wwerst/EE91Fall2020/README.md

# EE91Fall2020
EE91 Fall 2020 project with Junno
