wwerst/EE91Fall2020/CDR_Presentation.pdf

# Time-Domain Reflectometer CDR

Will Werst and Junno Tseng

High-Level Block Diagram

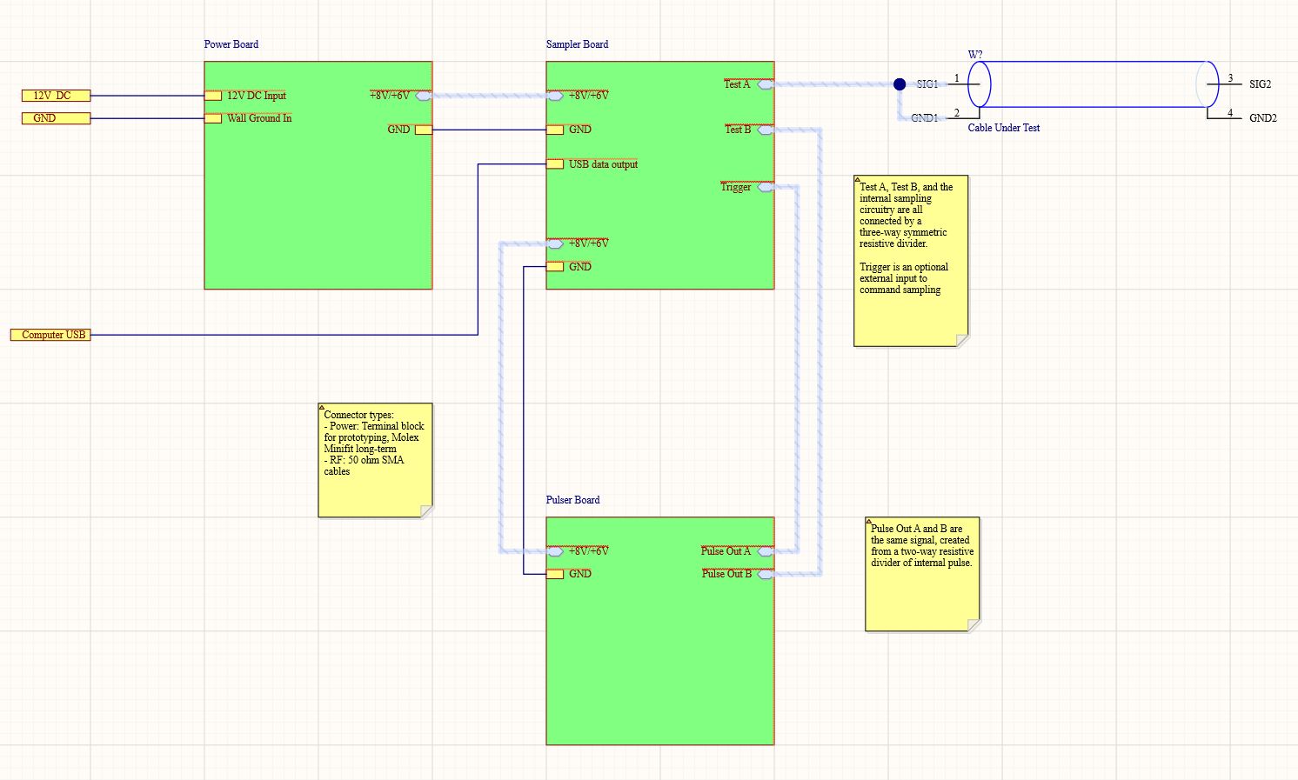
[picture p1: figure]
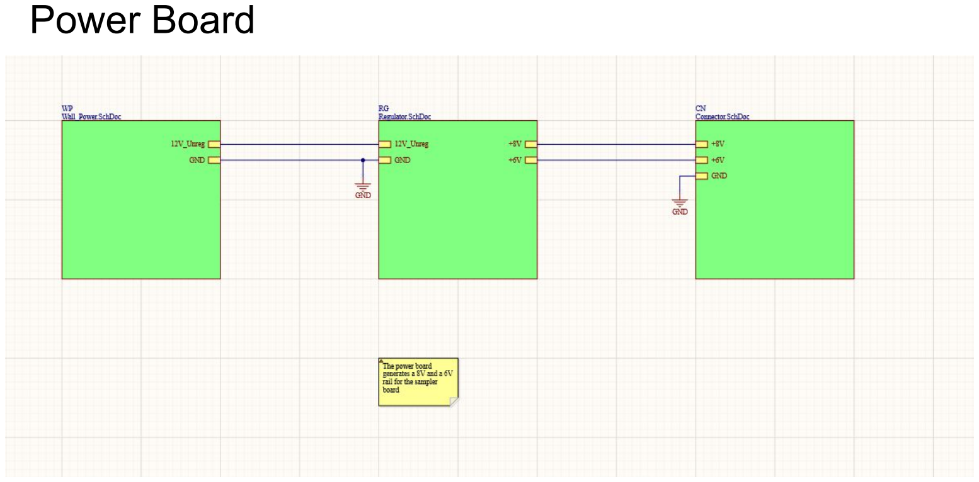
[picture p2: page 3]

Power Board

Pulser Board

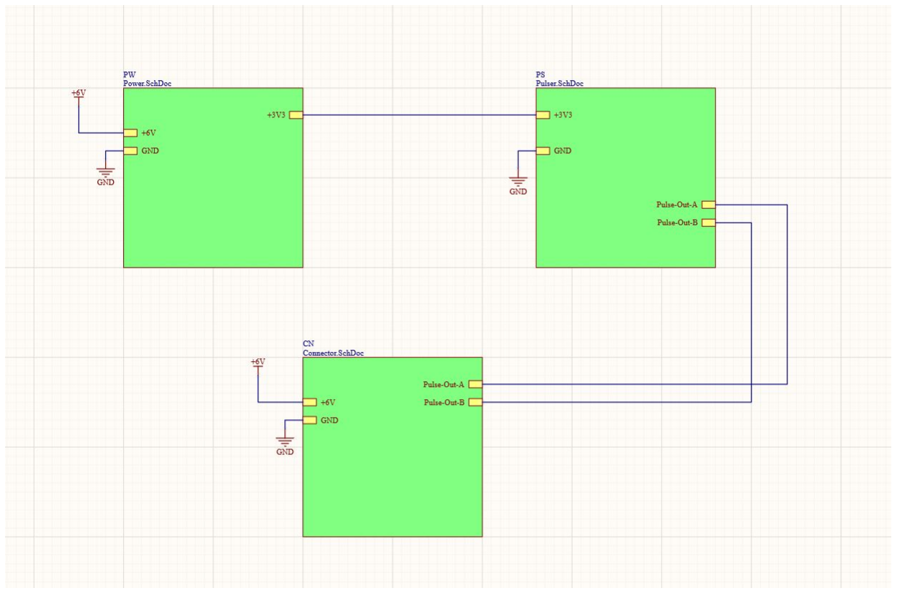
[picture p3: figure]

Sampler Board

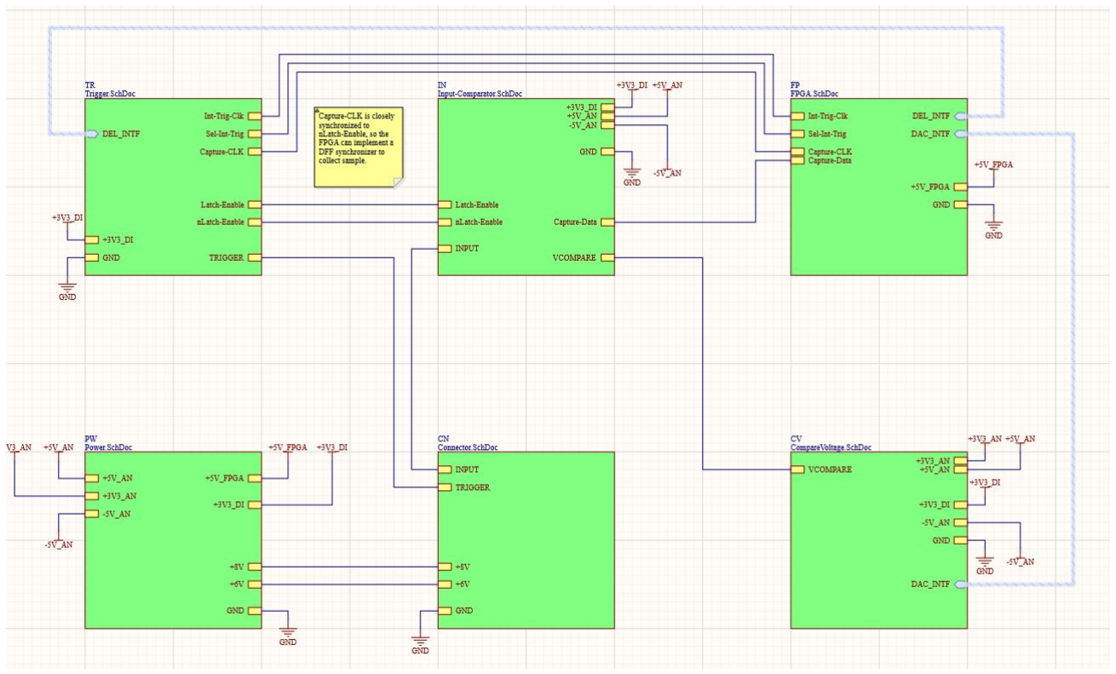
[picture p4: figure]

Power Board BOM

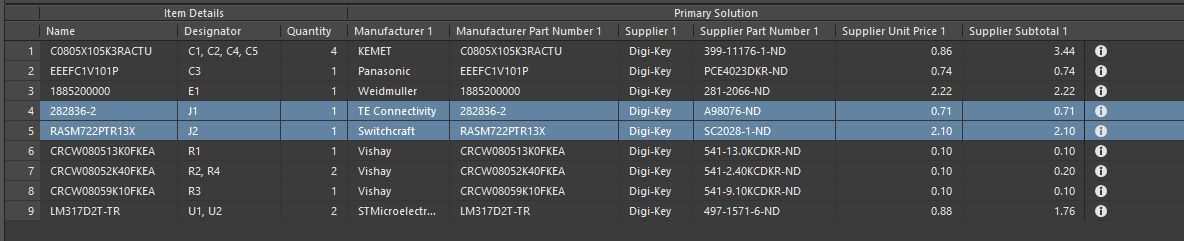
[picture p5: figure]

Pulse Board BOM

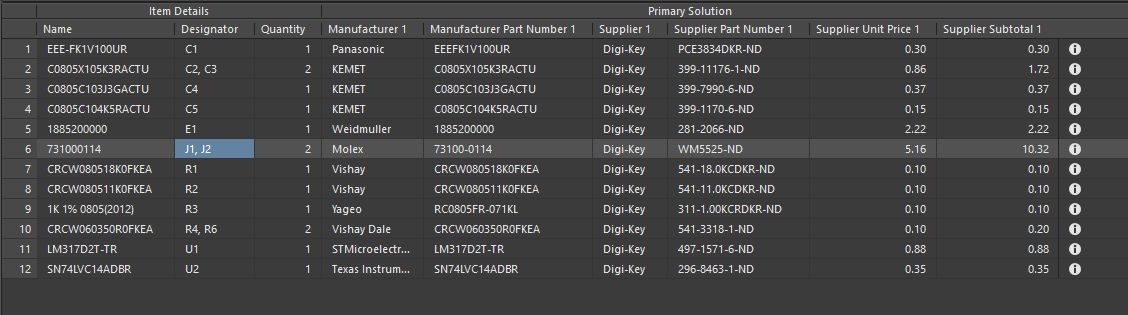
[picture p6: figure]

Sampler Board BOM

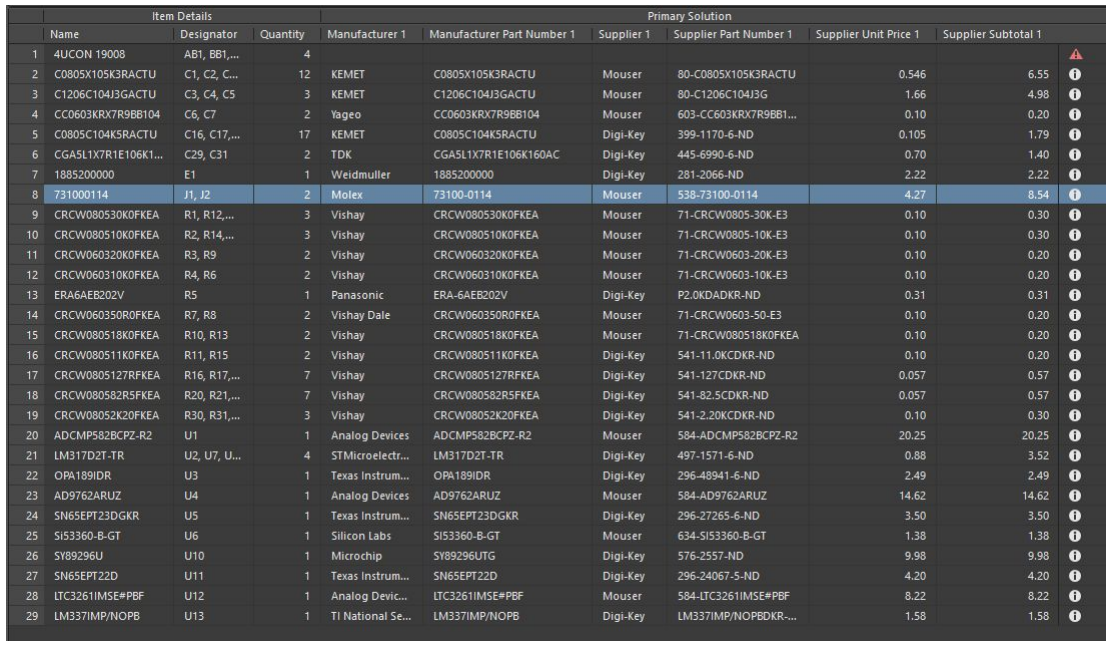
[picture p7: figure]

Move to Altium

See PDF of schematics as well

Appendix

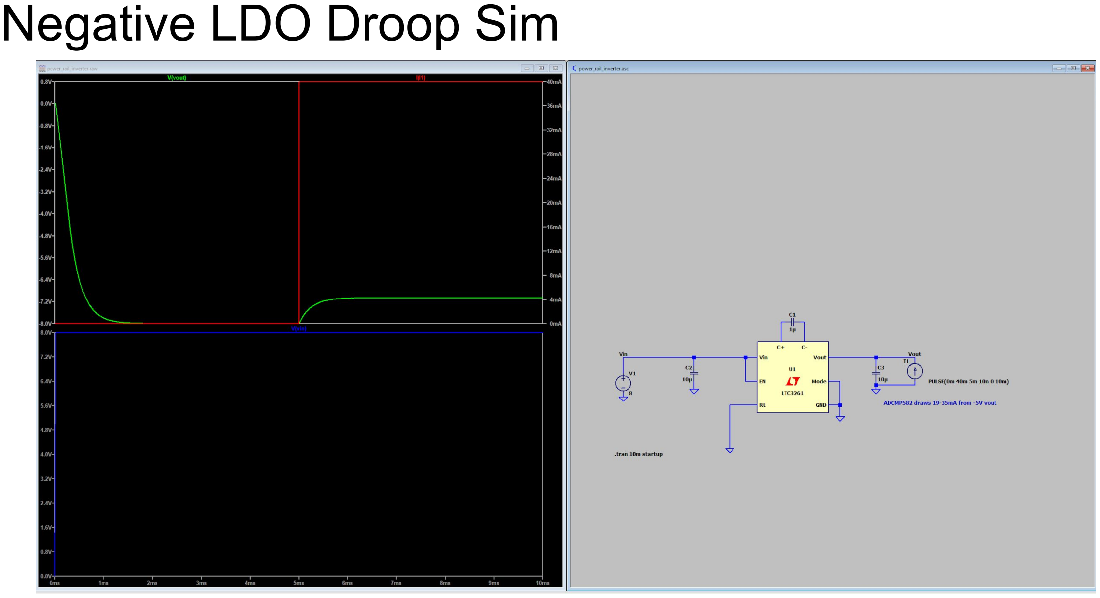
[picture p8: page 11]

Negative LDO Droop Sim
