wwerst/EE91Fall2020/PowerBoard/PowerBoard_BOM.xlsx

Name | Designator | Quantity | Manufacturer 1 | Manufacturer Part Number 1 | Supplier 1 | Supplier Part Number 1 | Supplier Unit Price 1 | Supplier Subtotal 1
C0805X105K3RACTU | C1, C2, C4, C5 | 4 | KEMET | C0805X105K3RACTU | Digi-Key | 399-11176-1-ND | $0.86 | $3.44
EEEFC1V101P | C3 | 1 | Panasonic | EEEFC1V101P | Digi-Key | PCE4023DKR-ND | $0.74 | $0.74
1885200000 | E1 | 1 | Weidmuller | 1885200000 | Digi-Key | 281-2066-ND | $2.22 | $2.22
282836-2 | J1 | 1 | TE Connectivity | 282836-2 | Digi-Key | A98076-ND | $0.71 | $0.71
RASM722PTR13X | J2 | 1 | Switchcraft | RASM722PTR13X | Digi-Key | SC2028-6-ND | $2.10 | $2.10
CRCW080513K0FKEA | R1 | 1 | Vishay | CRCW080513K0FKEA | Digi-Key | 541-13.0KCDKR-ND | $0.10 | $0.10
CRCW08052K40FKEA | R2, R4 | 2 | Vishay | CRCW08052K40FKEA | Digi-Key | 541-2.40KCDKR-ND | $0.10 | $0.20
CRCW08059K10FKEA | R3 | 1 | Vishay | CRCW08059K10FKEA | Digi-Key | 541-9.10KCDKR-ND | $0.10 | $0.10
LM317D2T-TR | U1, U2 | 2 | STMicroelectronics | LM317D2T-TR | Digi-Key | 497-1571-6-ND | $0.88 | $1.76
 |  |  |  |  |  |  | Total | $11.37
