wwerst/EE91Fall2020/PulseBoard/PulseBoard_BOM.xlsx

Name | Designator | Quantity | Manufacturer 1 | Manufacturer Part Number 1 | Supplier 1 | Supplier Part Number 1 | Supplier Unit Price 1 | Supplier Subtotal 1
EEE-FK1V100UR | C1 | 1 | Panasonic | EEEFK1V100UR | Digi-Key | PCE3834DKR-ND | $0.30 | $0.30
C0805X105K3RACTU | C2, C3 | 2 | KEMET | C0805X105K3RACTU | Digi-Key | 399-11176-1-ND | $0.86 | $1.72
C0805C103J3GACTU | C4 | 1 | KEMET | C0805C103J3GACTU | Digi-Key | 399-7990-6-ND | $0.37 | $0.37
C0805C104K5RACTU | C5 | 1 | KEMET | C0805C104K5RACTU | Digi-Key | 399-1170-6-ND | $0.15 | $0.15
1885200000 | E1 | 1 | Weidmuller | 1885200000 | Digi-Key | 281-2066-ND | $2.22 | $2.22
731000114 | J1, J2 | 2 | Molex | 73100-0114 | Digi-Key | WM5525-ND | $5.16 | $10.32
CRCW080518K0FKEA | R1 | 1 | Vishay | CRCW080518K0FKEA | Digi-Key | 541-18.0KCDKR-ND | $0.10 | $0.10
CRCW080511K0FKEA | R2 | 1 | Vishay | CRCW080511K0FKEA | Digi-Key | 541-11.0KCCT-ND | $0.10 | $0.10
1K 1% 0805(2012) | R3 | 1 | Yageo | RC0805FR-071KL | Digi-Key | 311-1.00KCRDKR-ND | $0.10 | $0.10
CRCW060350R0FKEA | R4, R6 | 2 | Vishay Dale | CRCW060350R0FKEA | Digi-Key | 541-3318-6-ND | $0.10 | $0.20
LM317D2T-TR | U1 | 1 | STMicroelectronics | LM317D2T-TR | Digi-Key | 497-1571-6-ND | $0.88 | $0.88
SN74LVC14ADBR | U2 | 1 | Texas Instruments | SN74LVC14ADBR | Digi-Key | 296-8463-1-ND | $0.35 | $0.35
 |  |  |  |  |  |  | Total Cost | $16.81
