wwerst/EE91Fall2020/SamplerBoard/SamplerBoard_BOM.xlsx

Name | Designator | Quantity | Manufacturer 1 | Manufacturer Part Number 1 | Supplier 1 | Supplier Part Number 1 | Supplier Unit Price 1 | Supplier Subtotal 1
4UCON 19008 | AB1, BB1, CB1, DB1 | 4 |  |  | Sparkfun | PRT-16890 | $1.50 | $6.00
5001 | TP1, TP2, TP7, TP8, TP9, TP10, TP11, TPGND1, TPGND2, TPGND3, TPGND4 | 11 | Keystone Electronics | 5001 | Digi-Key | 36-5001-ND | $0.40 | $4.40
731000114 | J1, J2 | 2 | Molex | 73100-0114 | Digi-Key | WM5525-ND | $5.16 | $10.32
1885200000 | E1 | 1 | Weidmuller | 1885200000 | Digi-Key | 281-2066-ND | $2.22 | $2.22
AD9762ARUZ | U4 | 1 | Analog Devices | AD9762ARUZ | Digi-Key | AD9762ARUZ-ND | $14.62 | $14.62
C0402C104K8PACTU | C14, C16, C17, C18, C19, C21, C22, C33 | 8 | KEMET | C0402C104K8PACTU | Digi-Key | 399-3027-6-ND | $0.04 | $0.32
C0805C104K5RACTU | C23, C24, C25, C26, C27, C28, C35, C36 | 8 | KEMET | C0805C104K5RACTU | Digi-Key | 399-1170-6-ND | $0.10 | $0.84
CC0603KRX7R9BB104 | C6, C7 | 2 | Yageo | CC0603KRX7R9BB104 | Digi-Key | 311-1344-6-ND | $0.10 | $0.20
CGA5L1X7R1E106K160AC | C29, C31 | 2 | TDK | CGA5L1X7R1E106K160AC | Digi-Key | 445-6990-6-ND | $0.70 | $1.40
CRCW08052K20FKEA | R30, R31, R32 | 3 | Vishay | CRCW08052K20FKEA | Digi-Key | 541-2.20KCDKR-ND | $0.10 | $0.30
CRCW060310K0FKEA | R4, R6 | 2 | Vishay | CRCW060310K0FKEA | Digi-Key | 541-10.0KHDKR-ND | $0.10 | $0.20
CRCW060320K0FKEA | R3, R9 | 2 | Vishay | CRCW060320K0FKEA | Digi-Key | 541-20.0KHDKR-ND | $0.10 | $0.20
CRCW060350R0FKEA | R7, R8 | 2 | Vishay Dale | CRCW060350R0FKEA | Digi-Key | 541-3318-6-ND | $0.10 | $0.20
CRCW080510K0FKEA | R2, R14, R34 | 3 | Vishay | CRCW080510K0FKEA | Digi-Key | 541-10.0KCDKR-ND | $0.10 | $0.30
CRCW080511K0FKEA | R11, R15 | 2 | Vishay | CRCW080511K0FKEA | Digi-Key | 541-11.0KCDKR-ND | $0.10 | $0.20
CRCW080518K0FKEA | R10, R13 | 2 | Vishay | CRCW080518K0FKEA | Digi-Key | 541-18.0KCDKR-ND | $0.10 | $0.20
CRCW080530K0FKEA | R1, R12, R33 | 3 | Vishay | CRCW080530K0FKEA | Digi-Key | 541-30.0KCDKR-ND | $0.10 | $0.30
ERA6AEB202V | R5 | 1 | Panasonic | ERA-6AEB202V | Digi-Key | P2.0KDADKR-ND | $0.31 | $0.31
LM317D2T-TR | U2, U7, U8, U9 | 4 | STMicroelectronics | LM317D2T-TR | Digi-Key | 497-1571-6-ND | $0.88 | $3.52
LM337IMP/NOPB | U13 | 1 | TI National Semiconductor | LM337IMP/NOPB | Digi-Key | LM337IMP/NOPBDKR-ND | $1.58 | $1.58
LTC3261IMSE#PBF | U12 | 1 | Analog Devices / Linear Technology | LTC3261IMSE#PBF | Digi-Key | LTC3261IMSE#PBF-ND | $8.24 | $8.24
OPA189IDR | U3 | 1 | Texas Instruments | OPA189IDR | Digi-Key | 296-48941-6-ND | $2.49 | $2.49
RC0402FR-0782R5L | R20, R21, R22, R23, R25 | 5 | Yageo | RC0402FR-0782R5L | Digi-Key | 311-82.5LRDKR-ND | $0.01 | $0.07
RC0402FR-07127RL | R16, R17, R18, R19, R24 | 5 | Yageo | RC0402FR-07127RL | Digi-Key | YAG2963DKR-ND | $0.01 | $0.07
SN65EPT22D | U11 | 1 | Texas Instruments | SN65EPT22D | Digi-Key | 296-24067-5-ND | $4.20 | $4.20
SN65EPT23DGKR | U5 | 1 | Texas Instruments | SN65EPT23DGKR | Digi-Key | 296-27265-6-ND | $3.50 | $3.50
127 Ohm | R26, R27 | 2 | Vishay | CRCW0805127RFKEA | Mouser | 71-CRCW0805127RFKEA | $0.10 | $0.20
ADCMP582BCPZ-R2 | U1 | 1 | Analog Devices | ADCMP582BCPZ-R2 | Mouser | 584-ADCMP582BCPZ-R2 | $20.25 | $20.25
C0805X105K3RACTU | C1, C2, C8, C9, C10, C11, C12, C13, C15, C30, C32 | 11 | KEMET | C0805X105K3RACTU | Mouser | 80-C0805X105K3RACTU | $0.55 | $6.01
C1206C104J3GACTU | C3, C4, C5 | 3 | KEMET | C1206C104J3GACTU | Mouser | 80-C1206C104J3G | $1.66 | $4.98
CRCW080582R5FKEA | R28, R29 | 2 | Vishay | CRCW080582R5FKEA | Mouser | 71-CRCW0805-82.5-E3 | $0.10 | $0.20
Si53360-B-GT | U6 | 1 | Silicon Labs | SI53360-B-GT | Mouser | 634-SI53360-B-GT | $1.38 | $1.38
Variable Digital Delay | U10 | 1 | Microchip | SY89296UTG | Mouser | 998-SY89296UTG | $9.98 | $9.98
 |  |  |  |  |  |  | Total Cost | $109.20
