wwerst/EE91Fall2020/CDR_Schematics.pdf

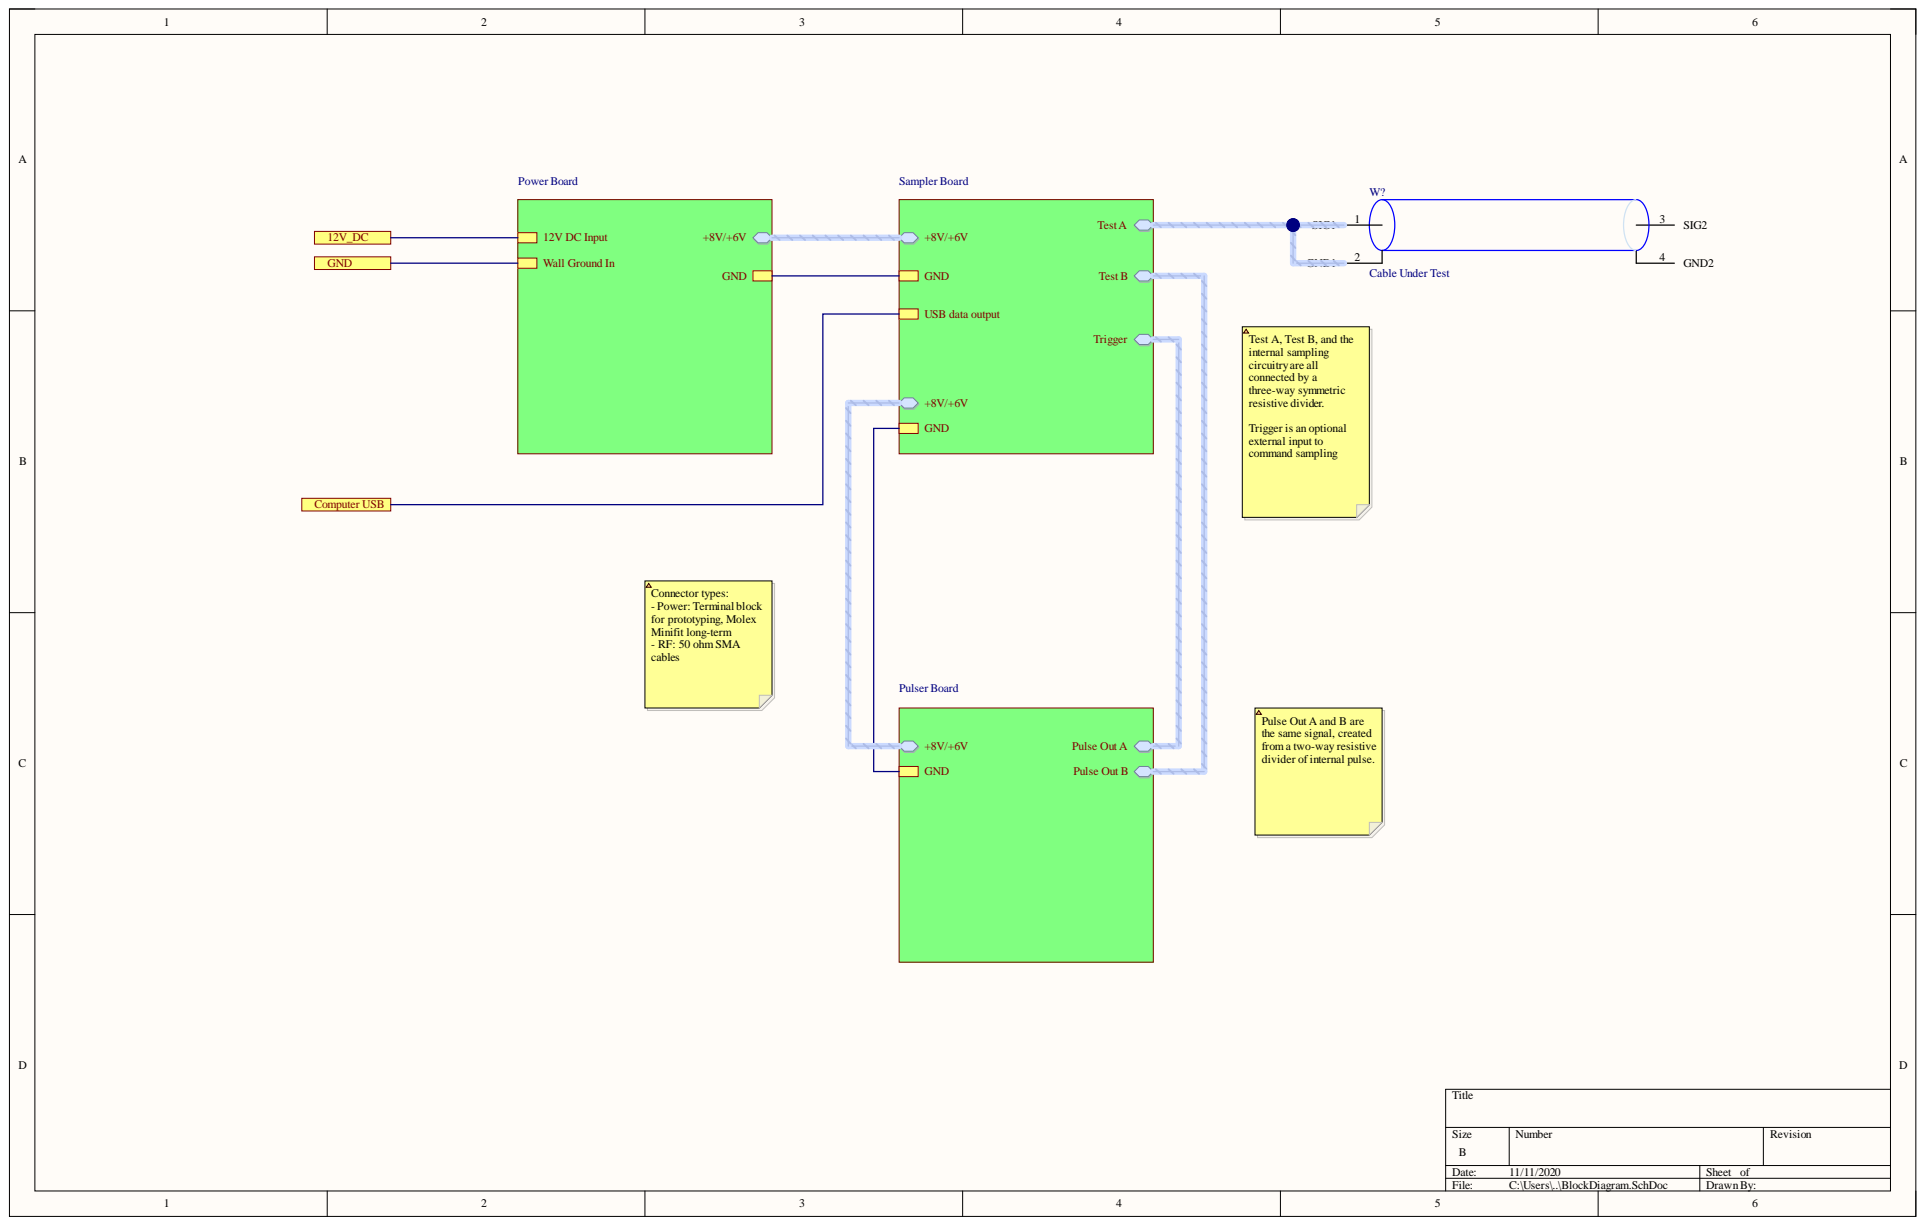
[picture p9: page 1]

Test A, Test B, and the
internal sampling
circuitryare all
connected by a
three-way symmetric
resistive divider.

Trigger is an optional
external input to
command sampling

Pulse Out A and B are
the same signal, created
from a two-way resistive
divider of internal pulse.

Size B | Number | Revision

Date: 11/11/2020 | Sheet of
File: C:\Users\..\BlockDiagram.SchDoc | DrawnBy:

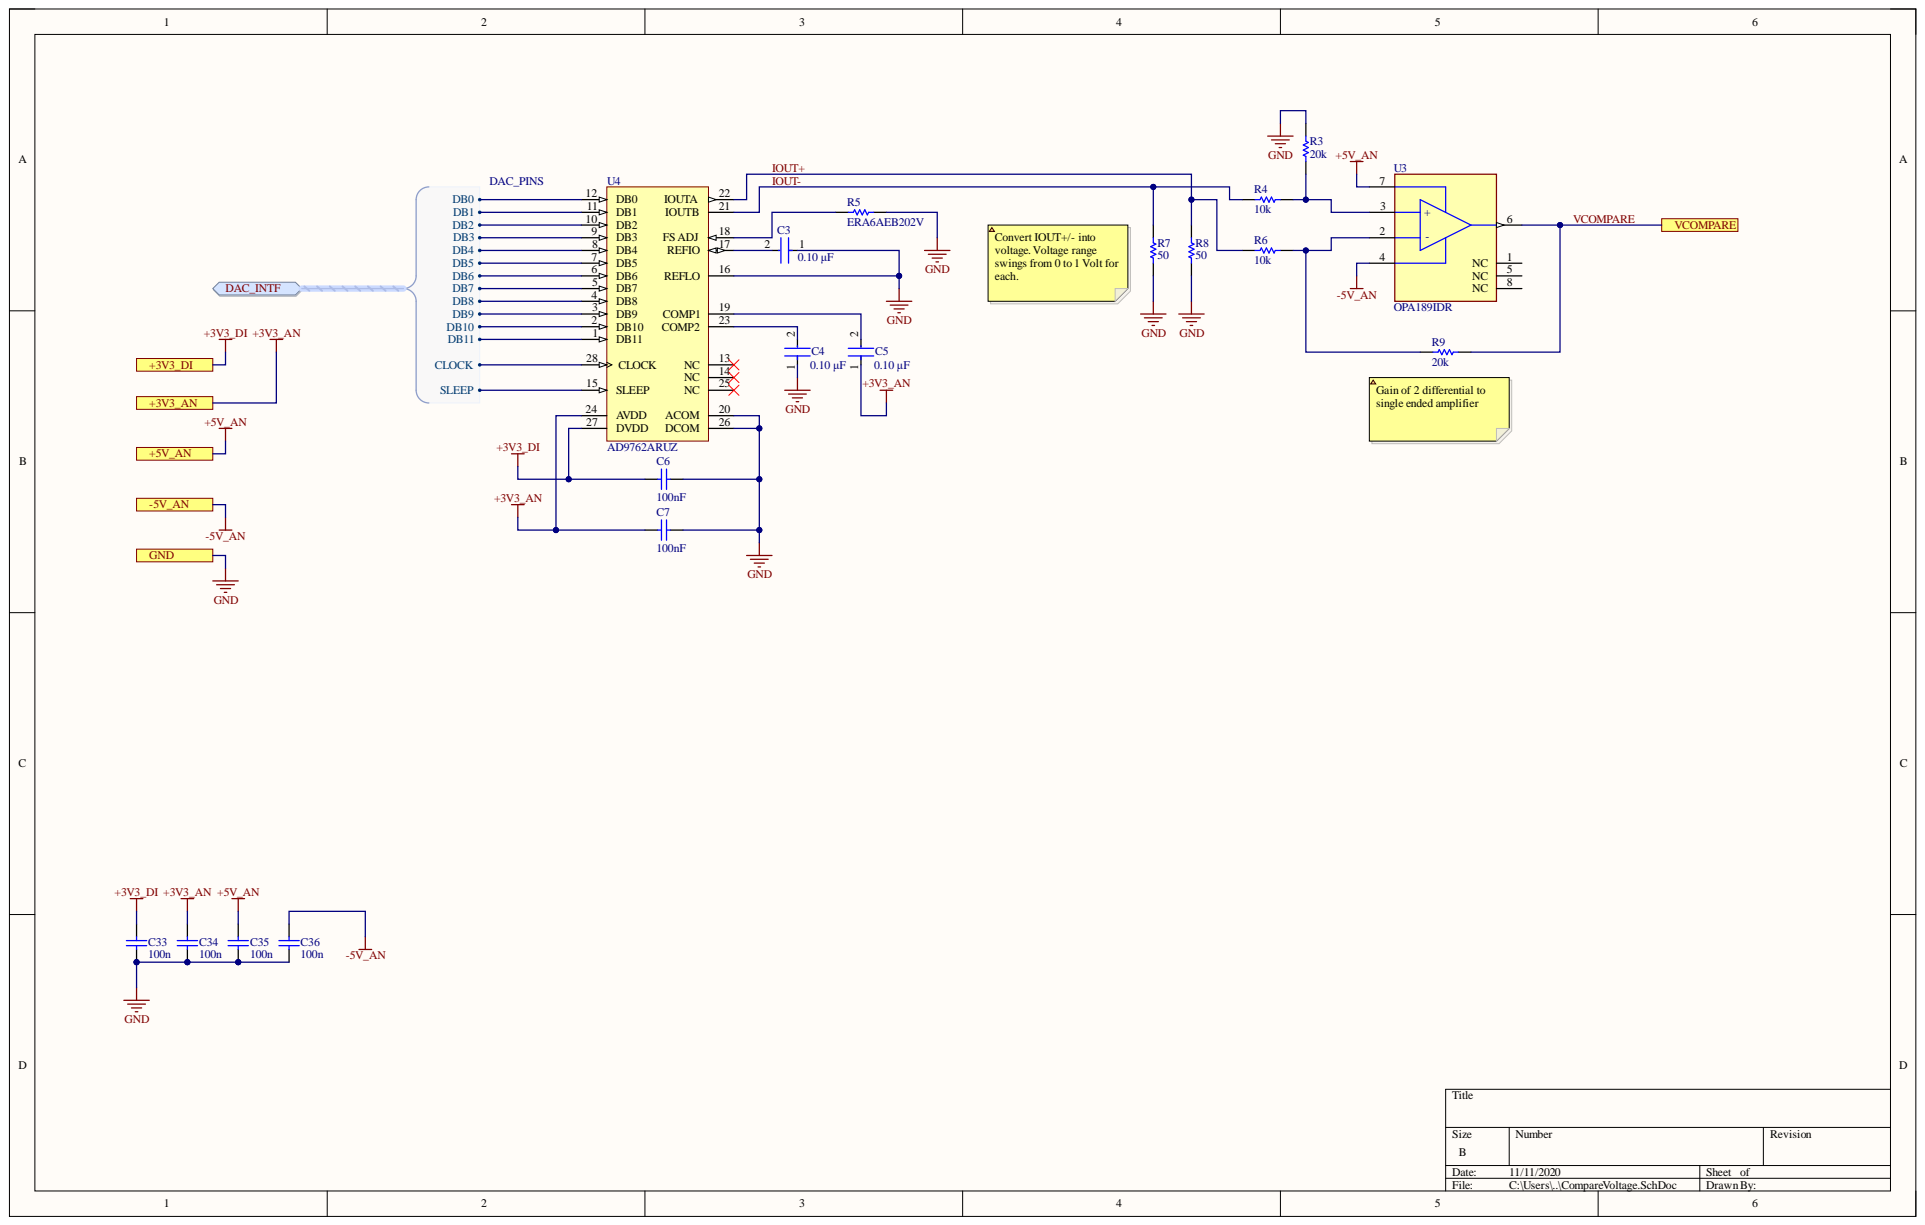
[picture p10: page 2]

Convert IOUT+/- into
voltage. Voltage range
swings from 0 to 1 Volt for
each.

Gain of 2 differential to
single ended amplifier

Size B | Number | Revision

Date: 11/11/2020 | Sheet of
File: C:\Users\..\CompareVoltage.SchDoc | DrawnBy:

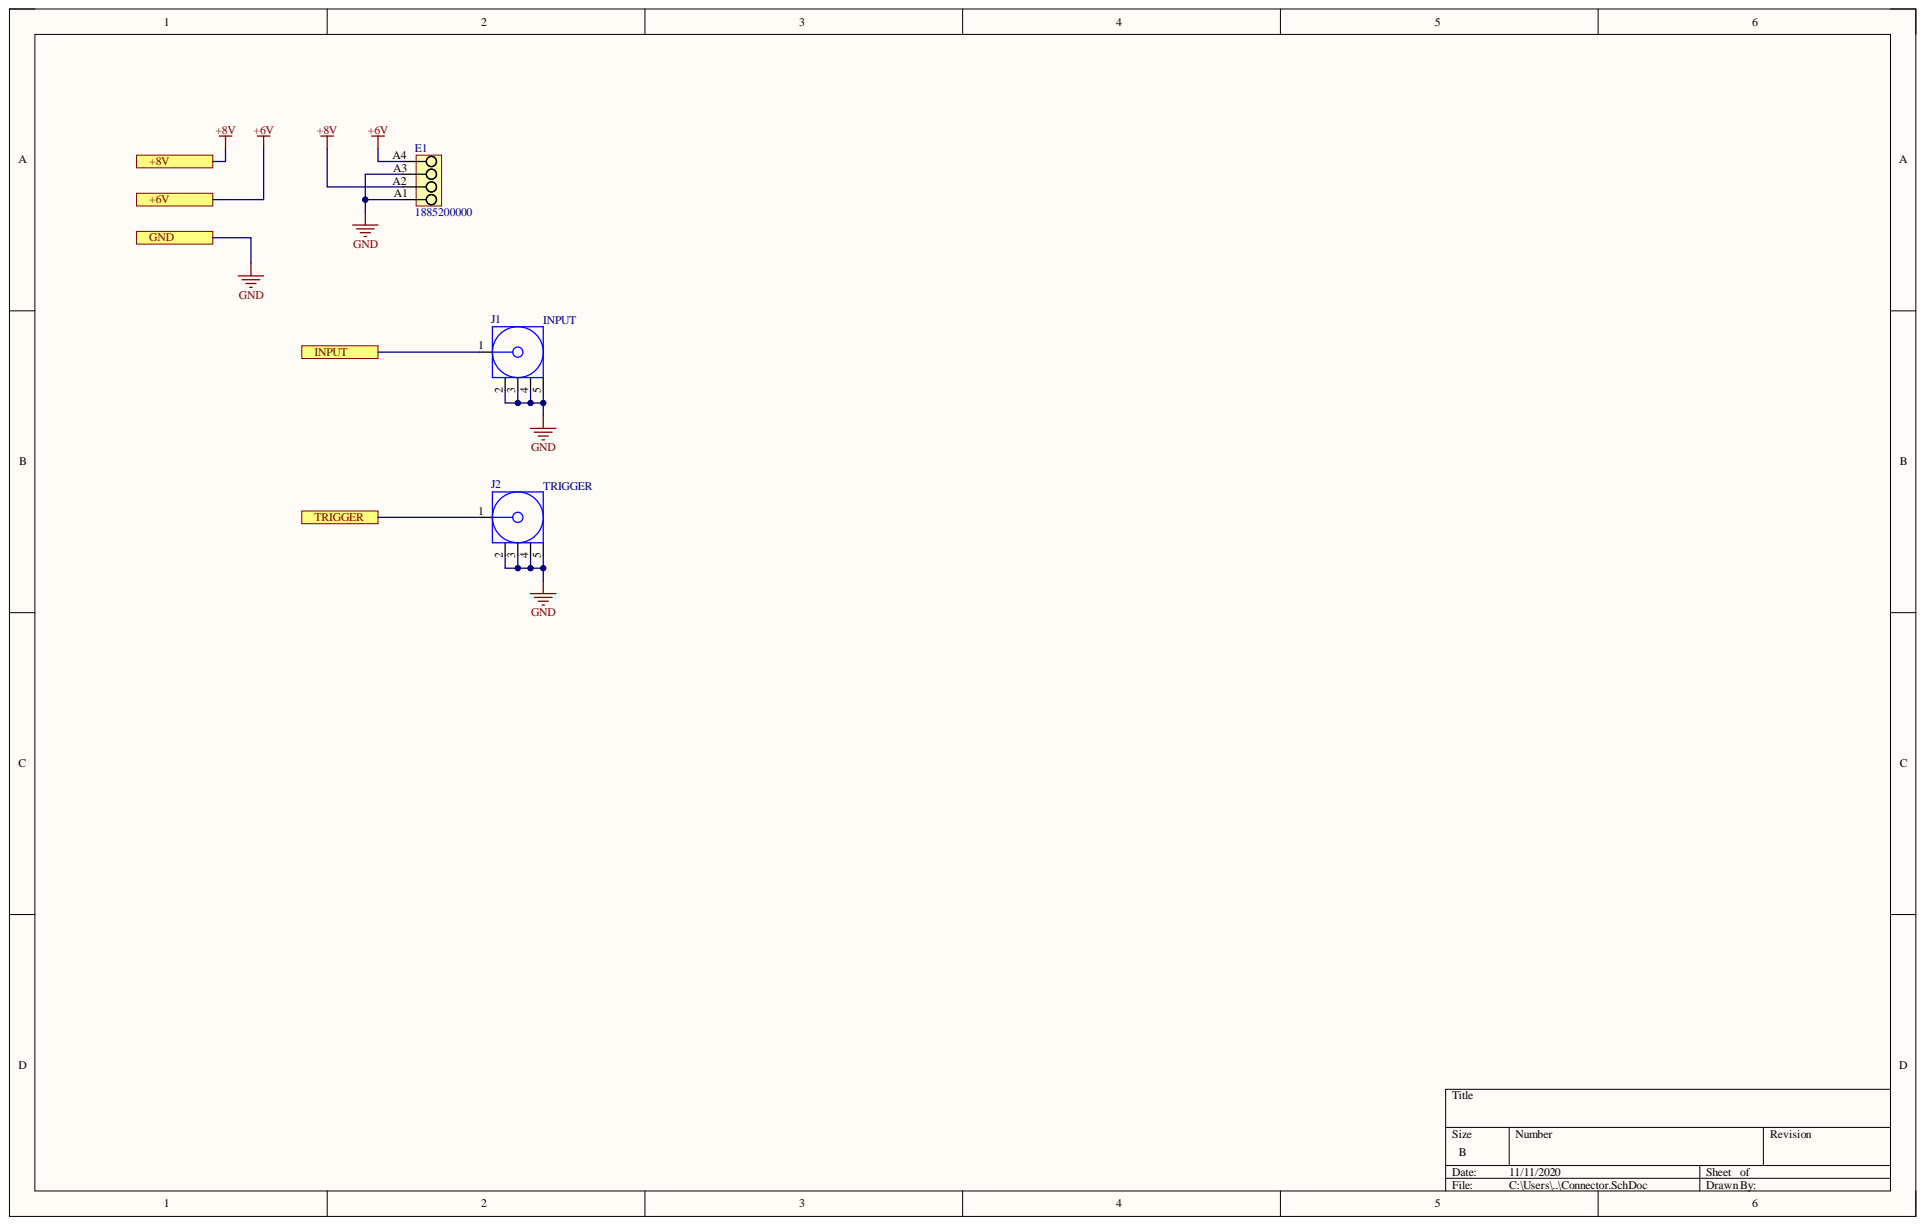
[picture p11: page 3]

Size B | Number | Revision

Date: 11/11/2020 | Sheet of
File: C:\Users\..\Connector.SchDoc | DrawnBy:

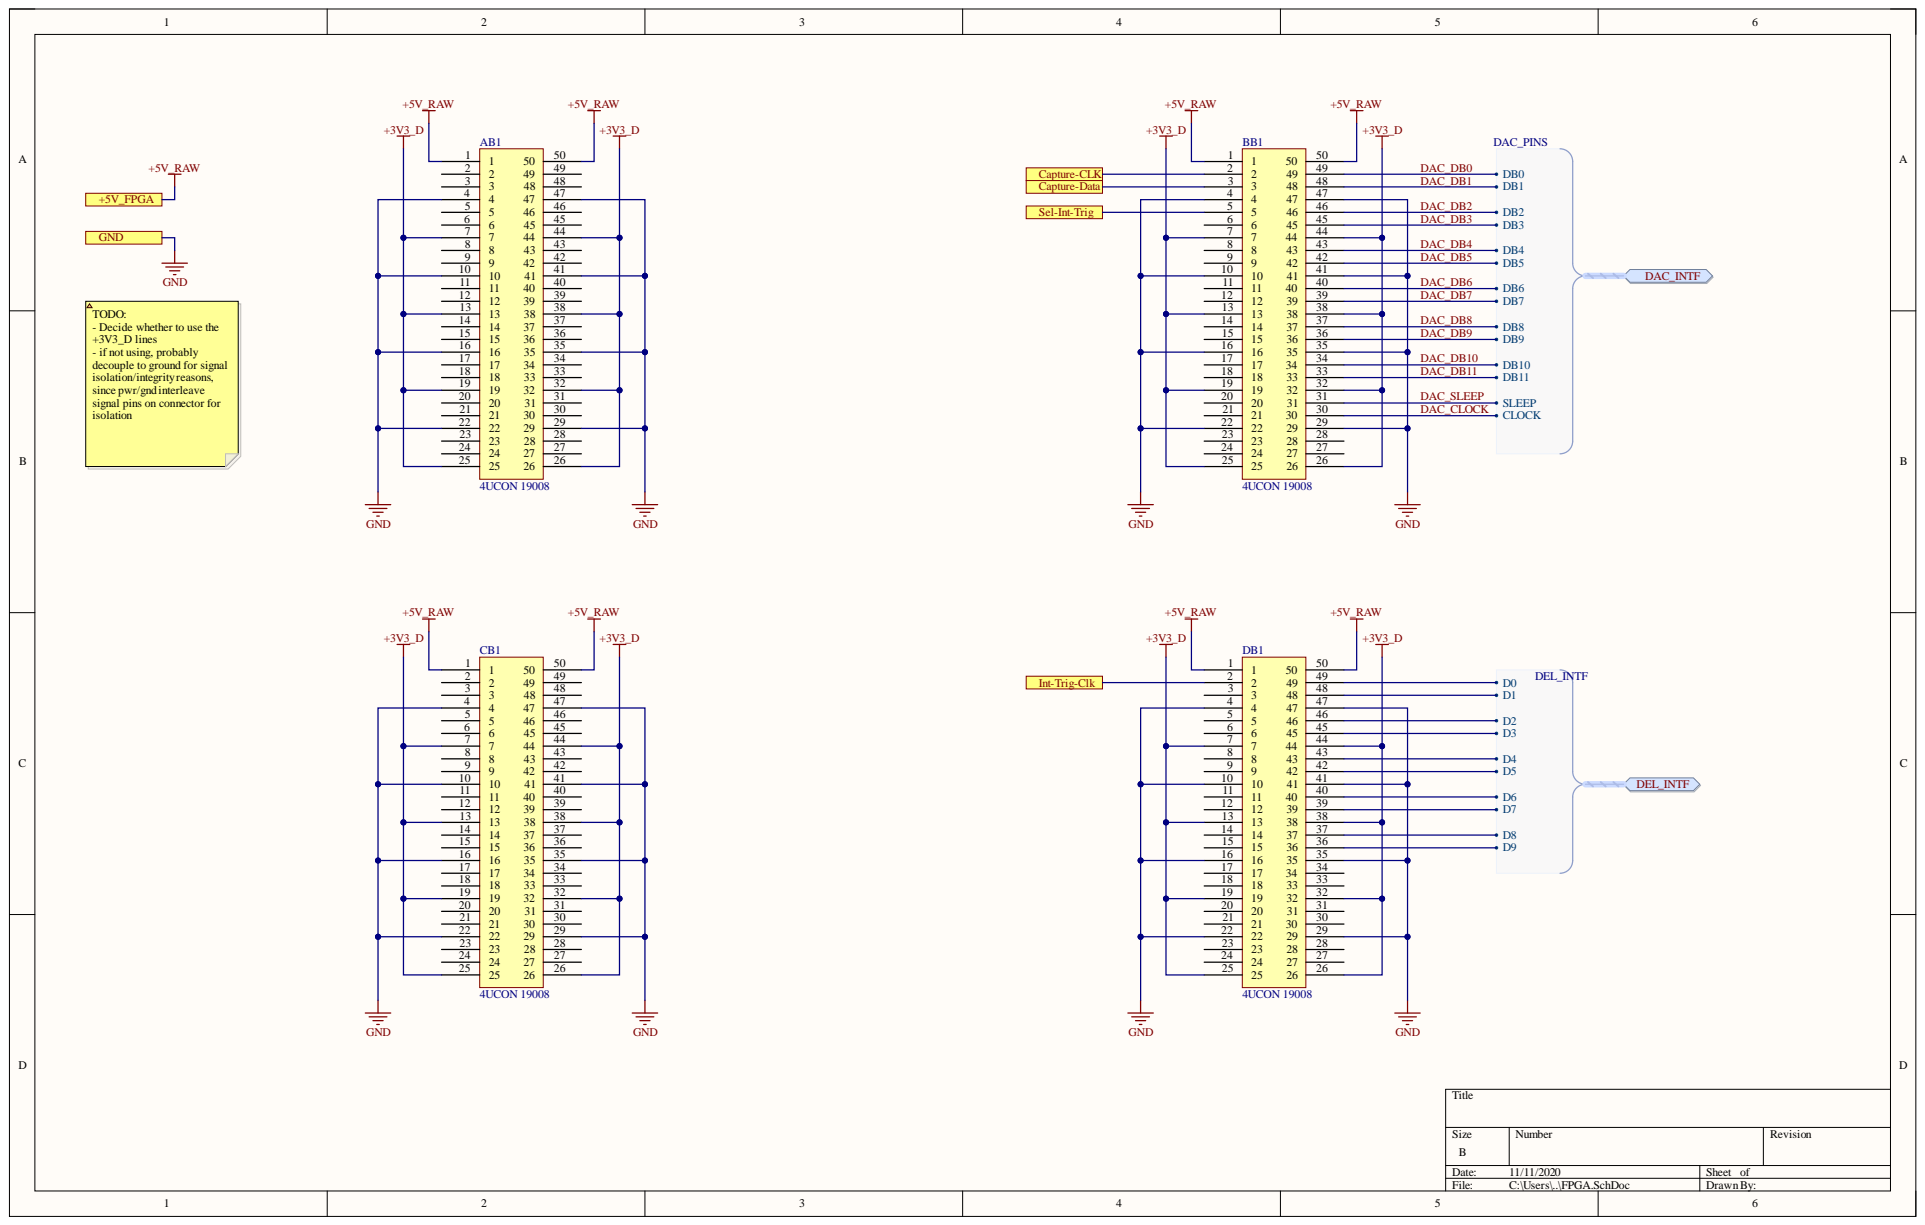
[picture p12: page 4]

Si z e | N umber | Revi s i on

e : 11/ 11/20 20 | Sheet of
Fi l e : C : \User s \..\FPG A.Sch Doc | D raw n B y :

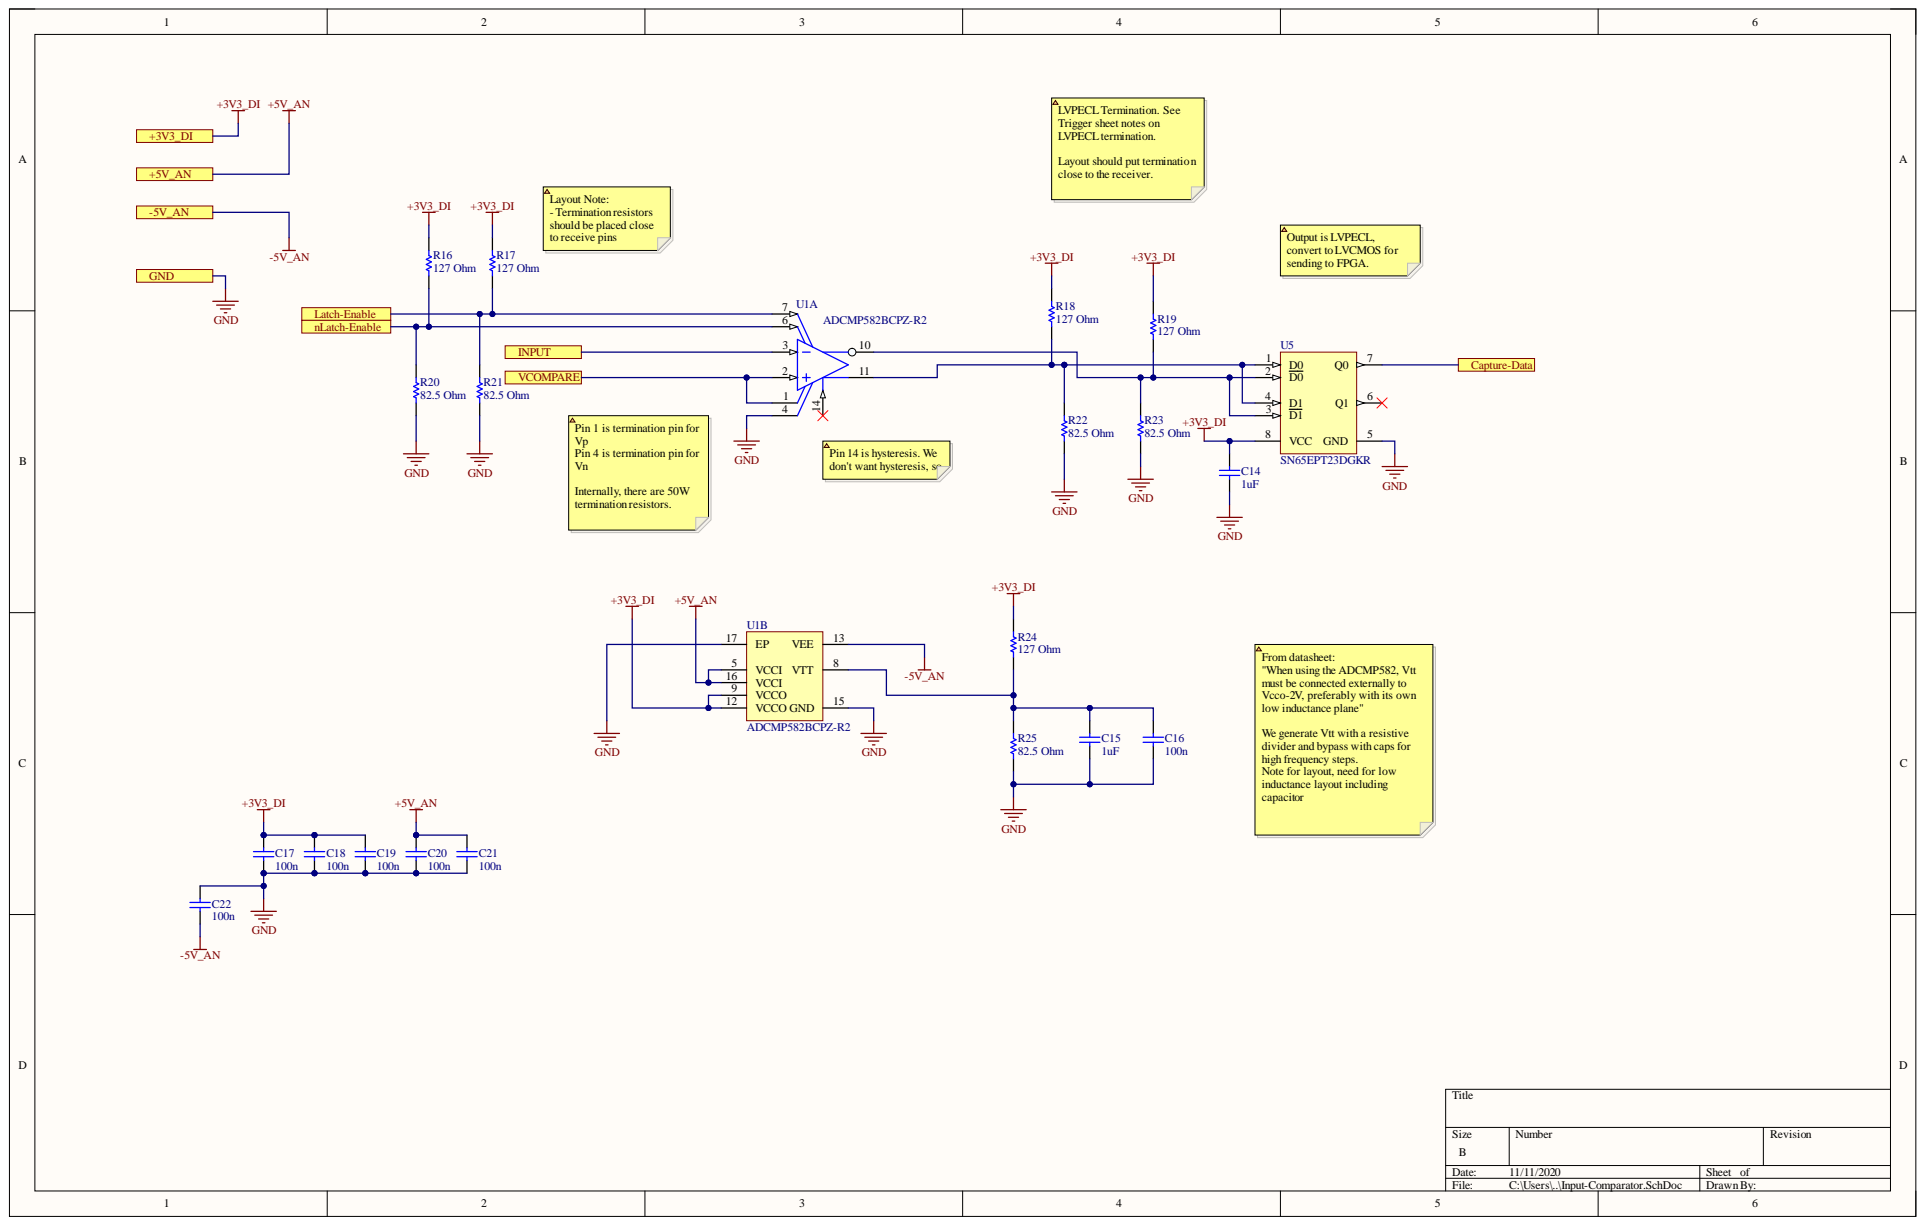
[picture p13: page 5]

LVPECL Termination. See
Trigger sheet notes on
LVPECL termination.

Layout should put termination
close to the receiver.

Layout Note:
- Terminationresistors
should be placed close
to receive pins

Output is LVPECL,
convert to LVCMOS for
sending to FPGA.

Pin 1 is termination pin for
Pin 4 is termination pin for

Pin 14 is hysteresis. We
don't want hysteresis, so

From datasheet:
"When using the ADCMP582, Vtt
must be connected externally to
Vcco-2V, preferably with its own
low inductance plane"

VCCI 16 | -5V_AN
VCCO 9
VCCO 12

We generate Vtt with a resistive
divider and bypass with caps for
high frequency steps.
Note for layout, need for low
inductance layout including
capacitor

Size B | Number | Revision

Date: 11/11/2020 | Sheet of
File: C:\Users\..\Input-Comparator.SchDoc | DrawnBy:

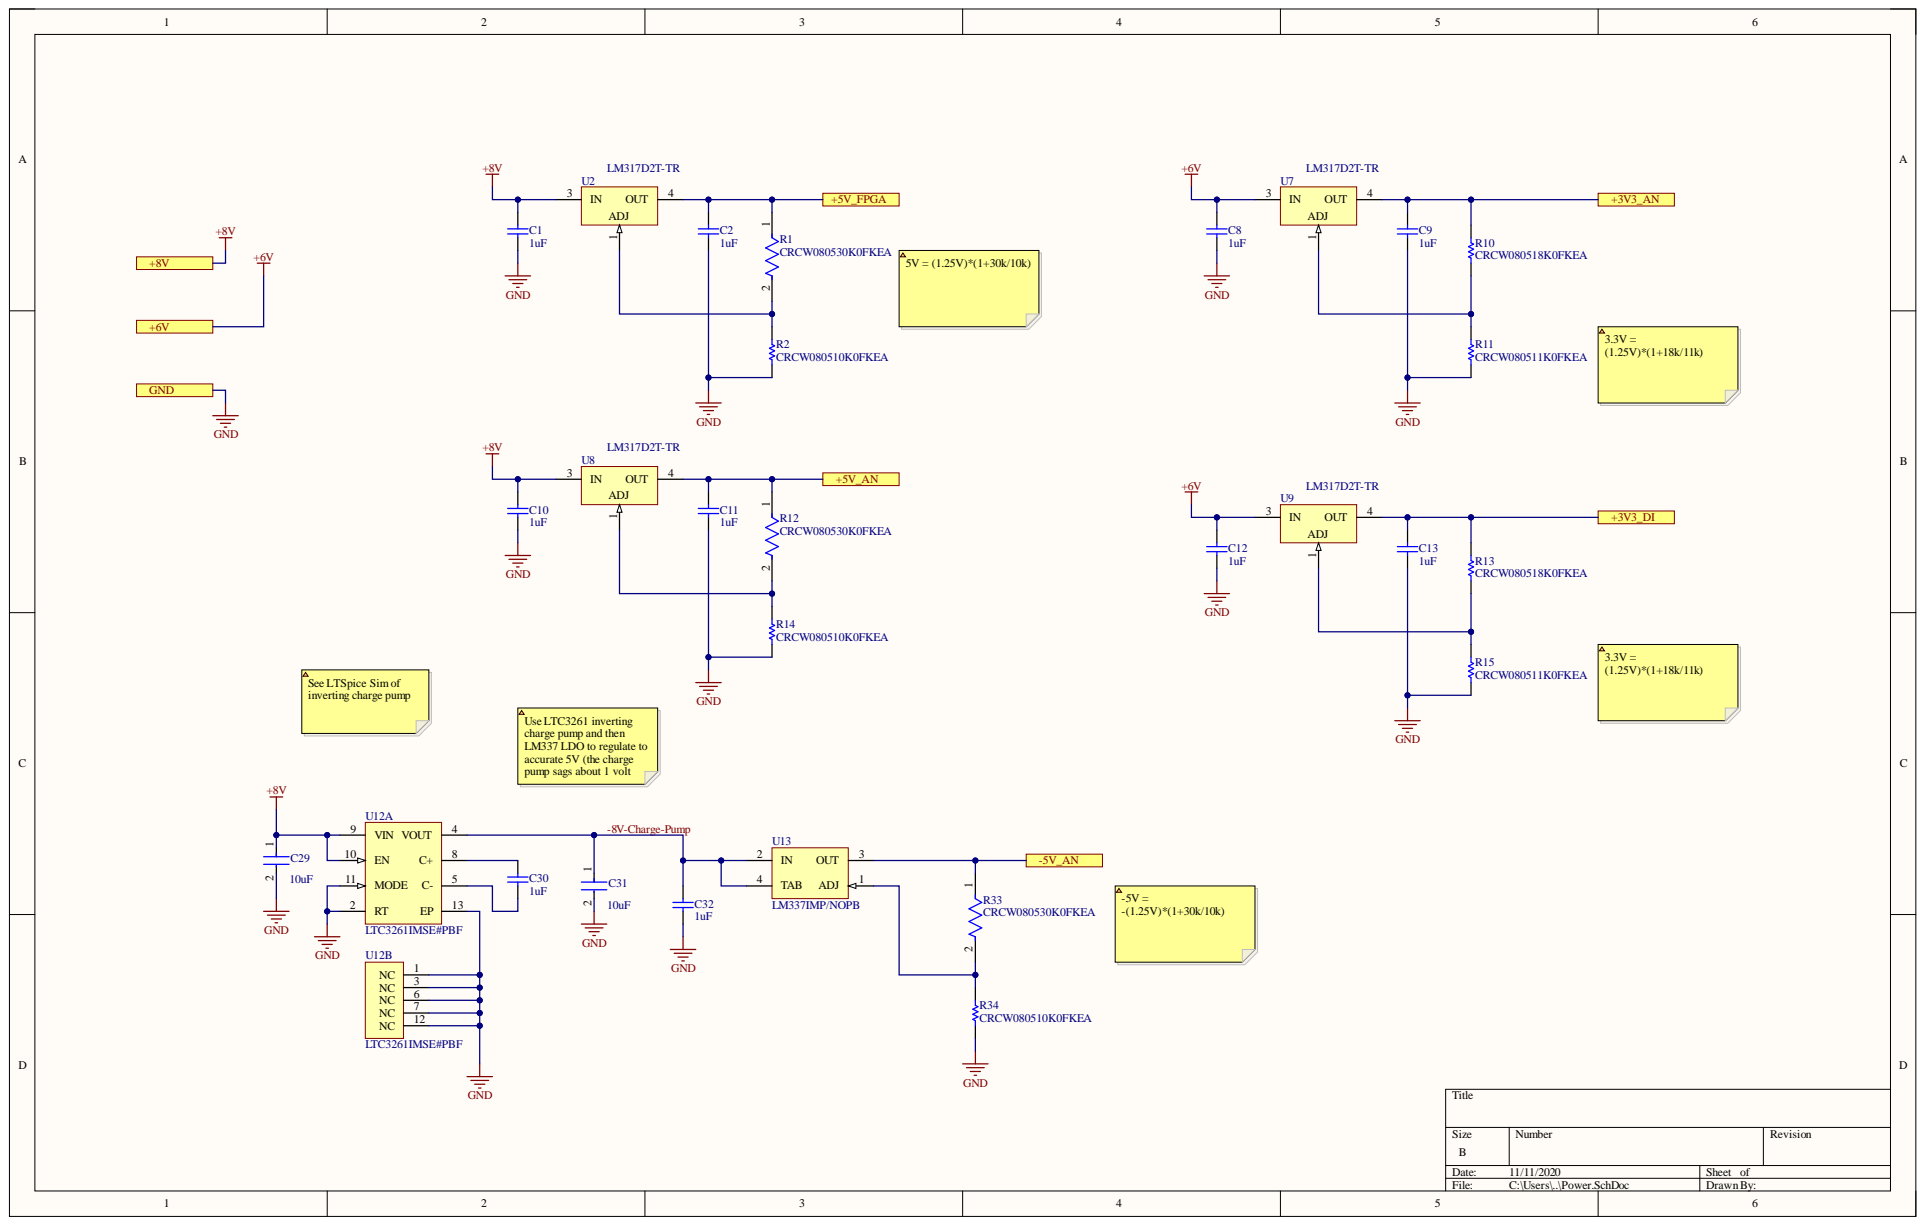
[picture p14: page 6]

charge pump and then pump sags about 1 volt | +5V_AN

See LTSpice Sim of
inverting charge pump

LM337 LDO to regulate to
accurate 5V (the charge

MODE 11

Size B | Number | Revision

Date: 11/11/2020 | Sheet of
File: C:\Users\..\Power.SchDoc | DrawnBy:

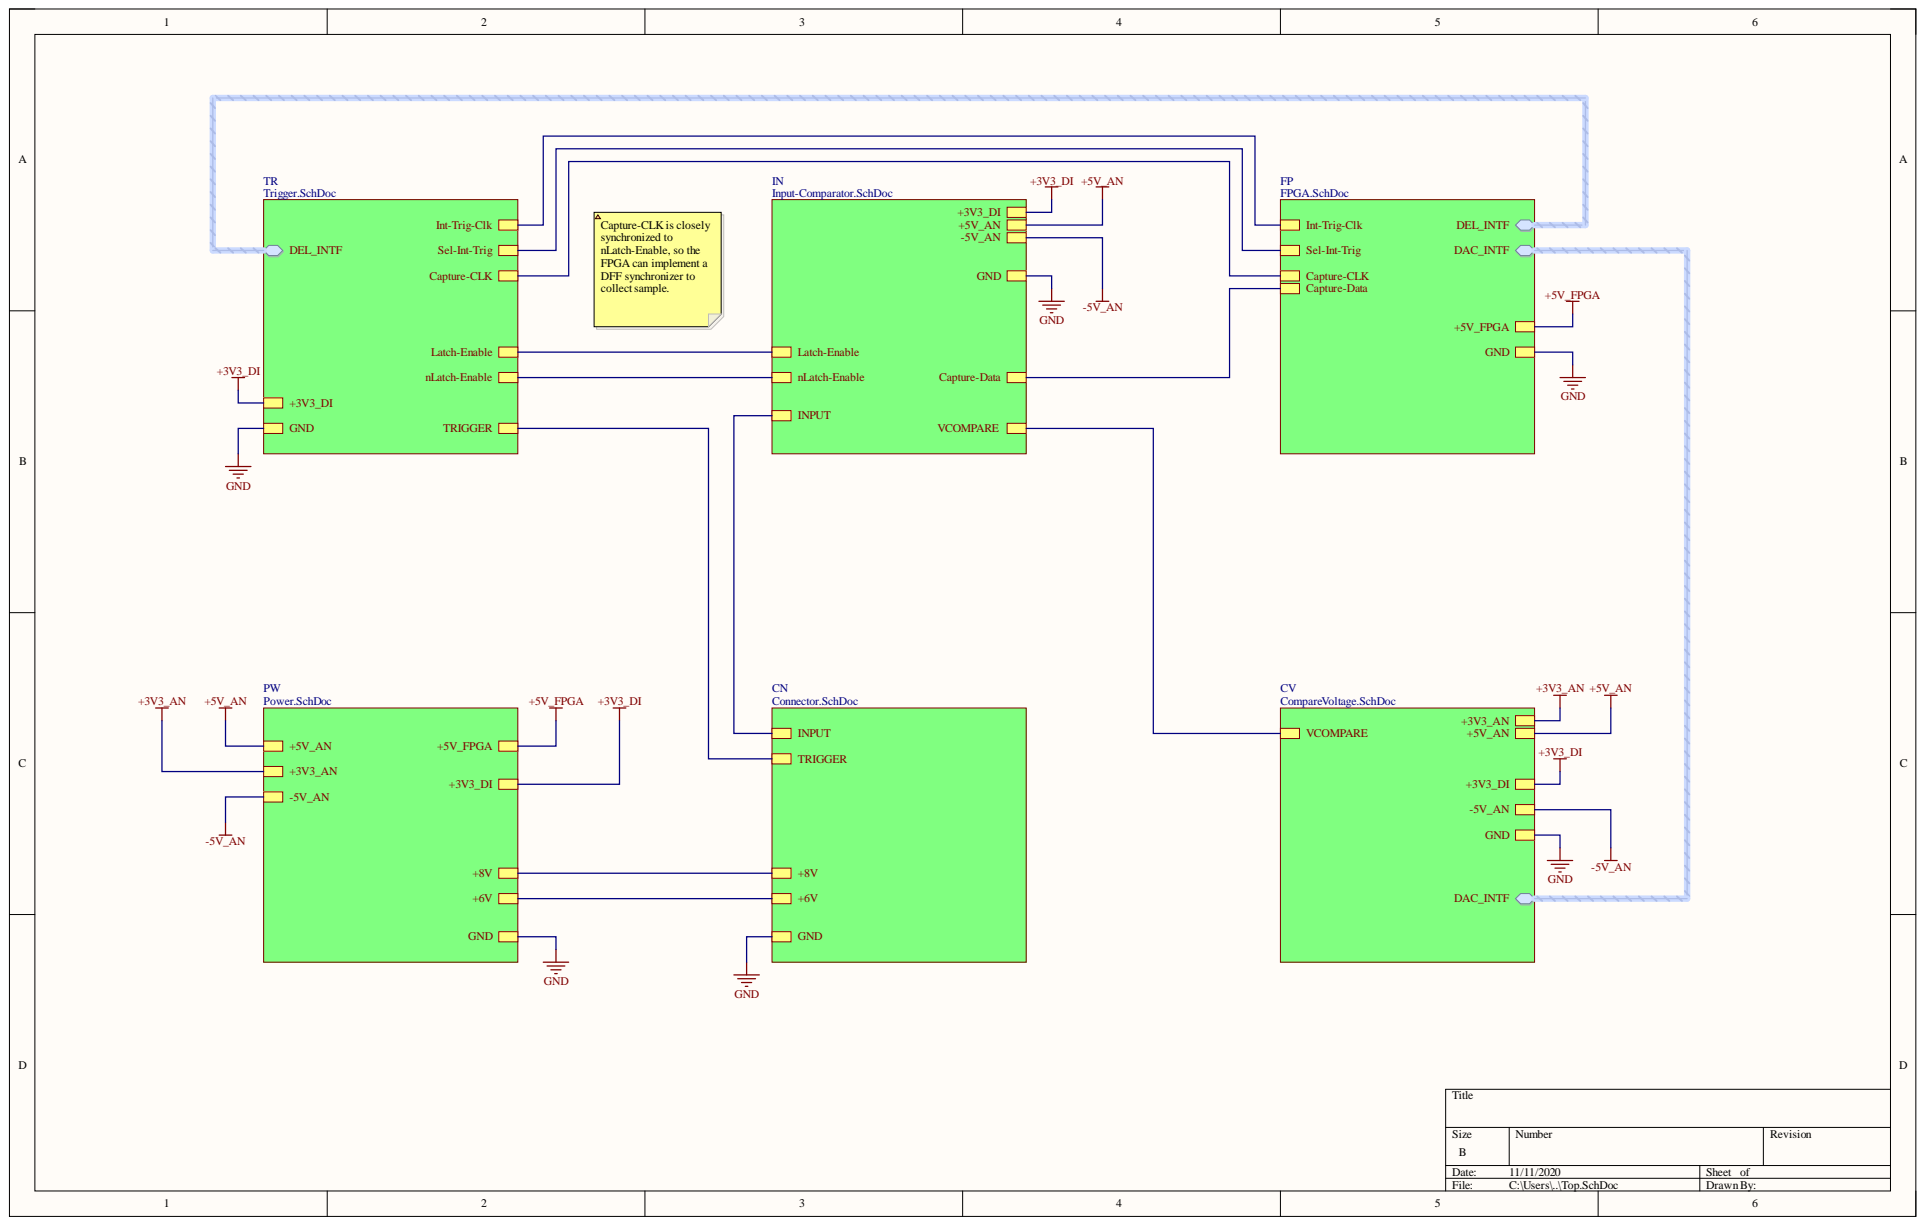
[picture p15: page 7]

Capture-CLK is closely
synchronized to
nLatch-Enable, so the
FPGA can implement a
DFF synchronizer to
collectsample.

Size B | Number | Revision

Date: 11/11/2020 | Sheet of
File: C:\Users\..\Top.SchDoc | DrawnBy:

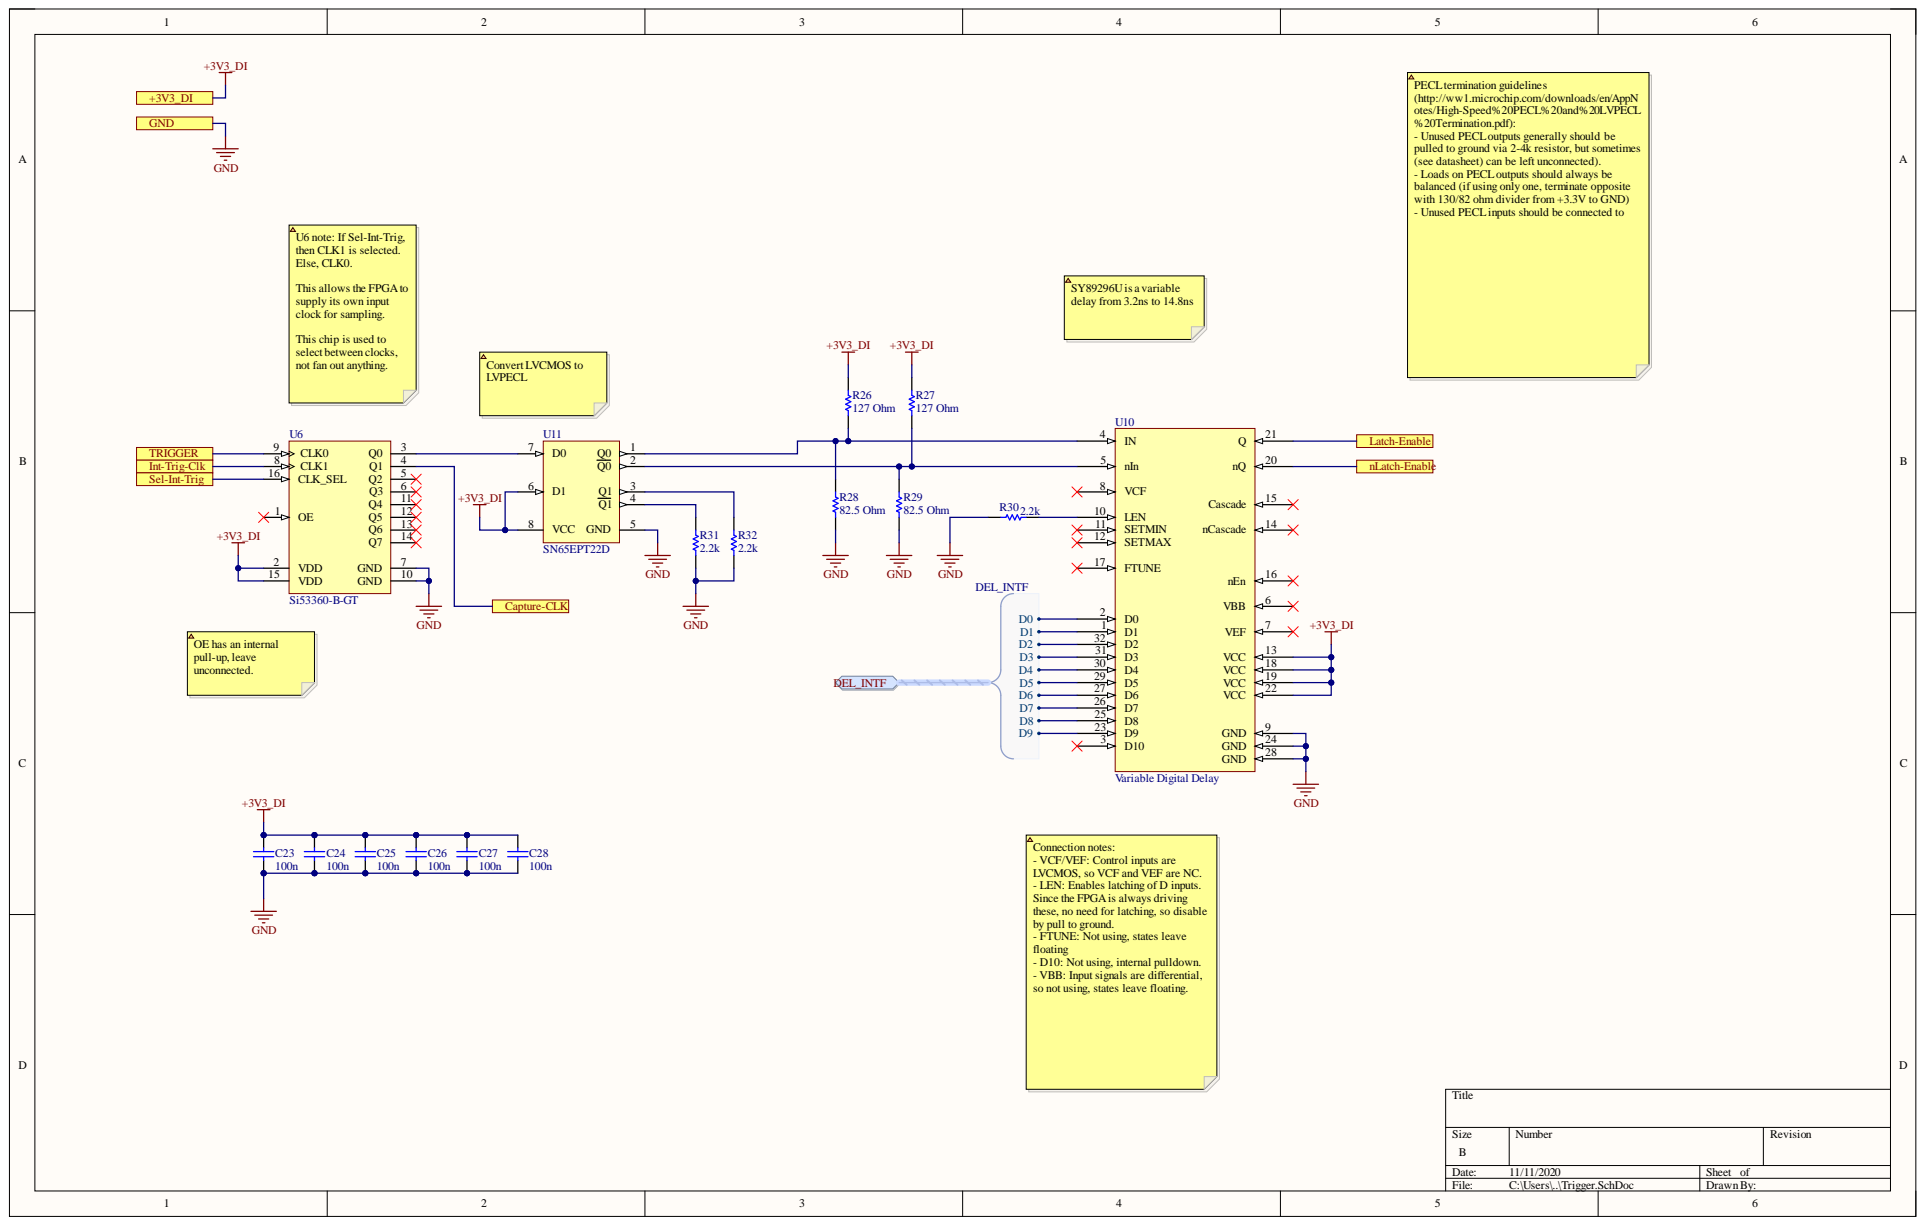
[picture p16: page 8]

PECL termination guidelines
(http://ww1.microchip.com/downloads/en/AppN
otes/High-Speed%20PECL%20and%20LVPECL
%20Termination.pdf):
- Unused PECL outputs generally should be
pulled to ground via 2-4k resistor, but sometimes
(see datasheet) can be left unconnected).
- Loads on PECL outputs should always be
balanced (if using only one, terminate opposite
with 130/82 ohm divider from +3.3V to GND)
- Unused PECL inputs should be connected to

U6 note: If Sel-Int-Trig,
then CLK1 is selected.
Else, CLK0.

This allows the FPGAto
supply its own input
clock for sampling.

This chip is used to
select between clocks,
not fan out anything.

OE has an internal
pull-up, leave
unconnected.

Connection notes:
- VCF/VEF: Control inputs are
LVCMOS, so VCF and VEF are NC.
- LEN: Enables latching of D inputs.
Since the FPGAis always driving
these, no need for latching, so disable
by pull to ground.
- FTUNE: Not using, states leave
floating
- D10: Not using, internal pulldown.
- VBB: Input signals are differential,
so not using, states leave floating.

Size B | Number | Revision

Date: 11/11/2020 | Sheet of
File: C:\Users\..\Trigger.SchDoc | DrawnBy:

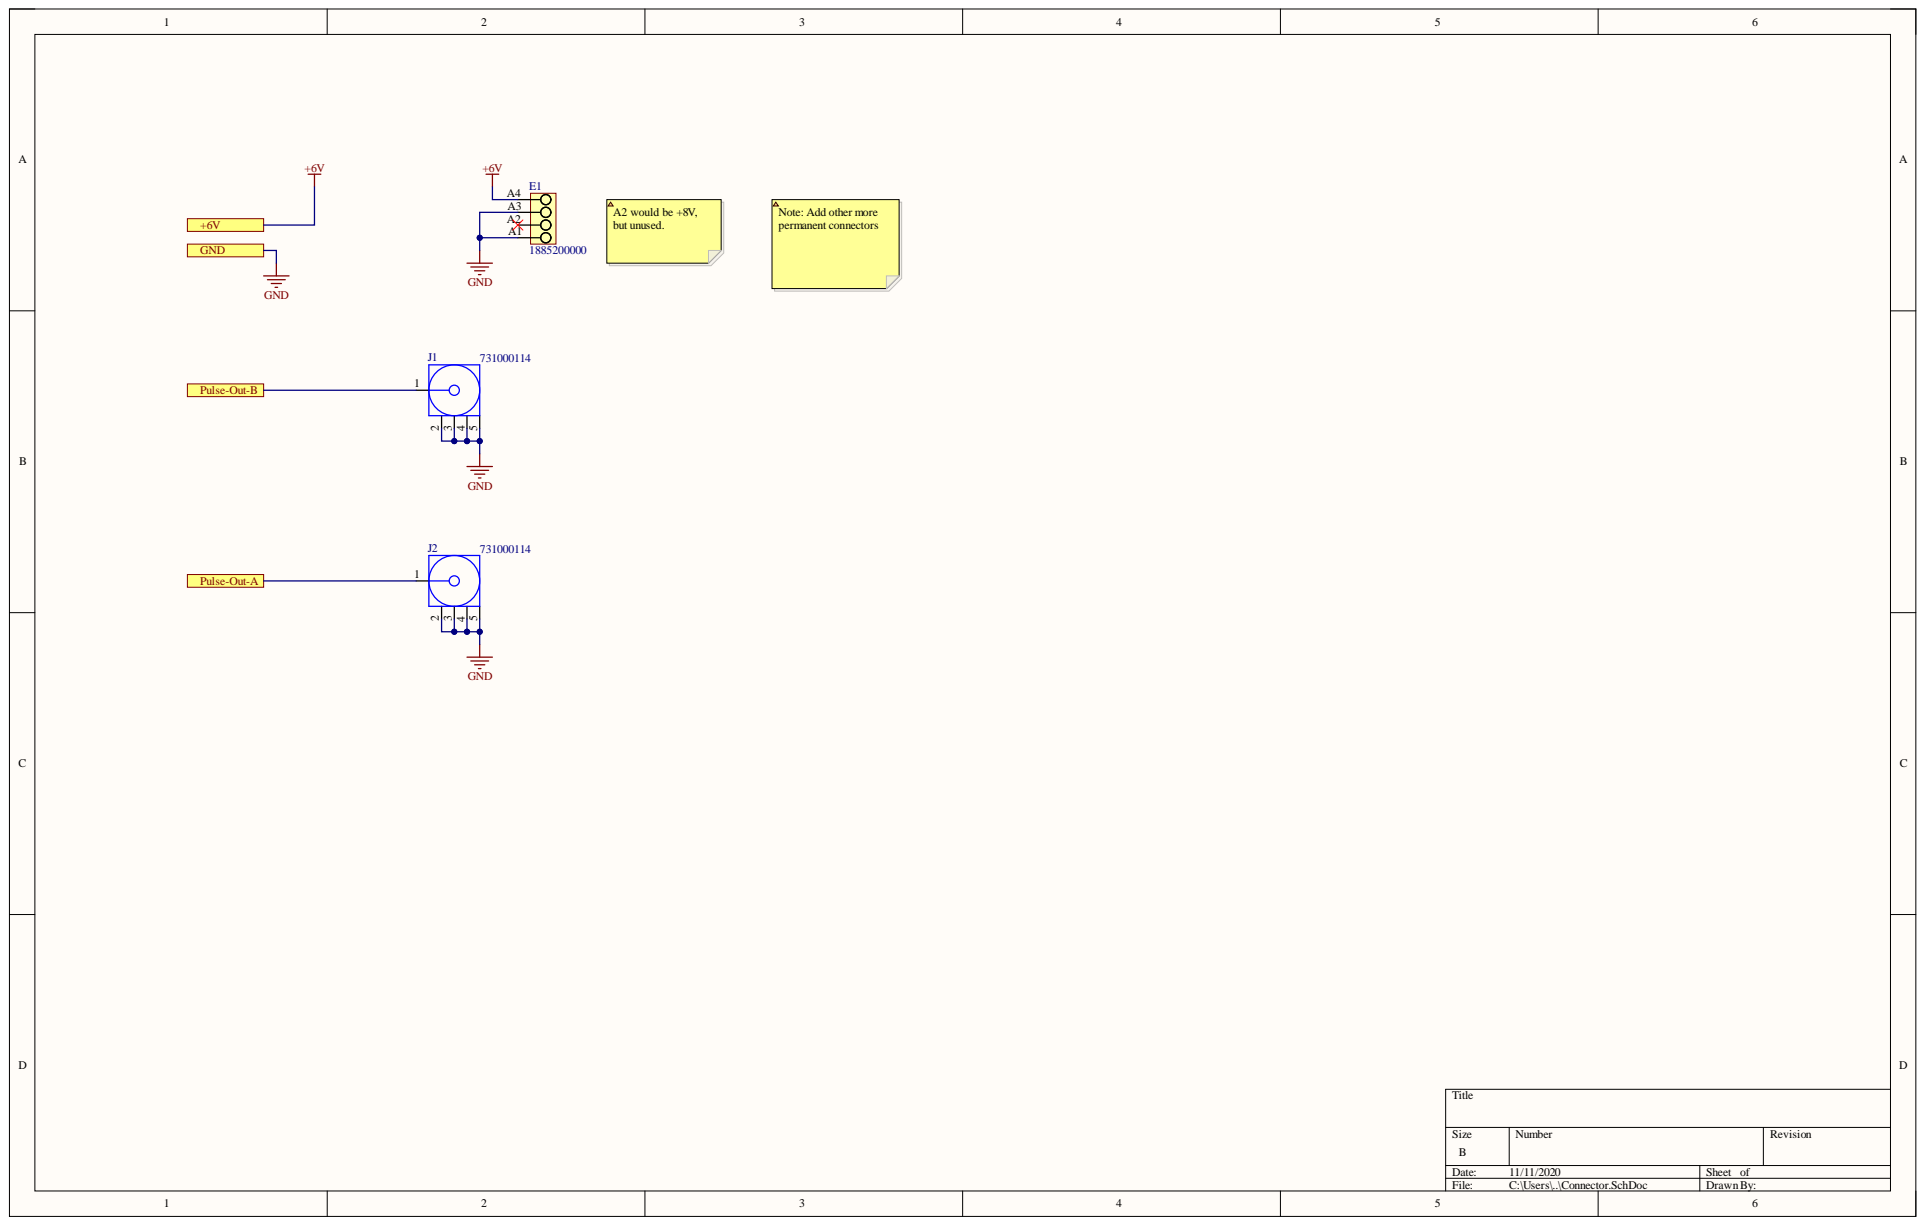
[picture p17: page 9]

Note: Add other more
permanent connectors

Size B | Number | Revision

Date: 11/11/2020 | Sheet of
File: C:\Users\..\Connector.SchDoc | DrawnBy:

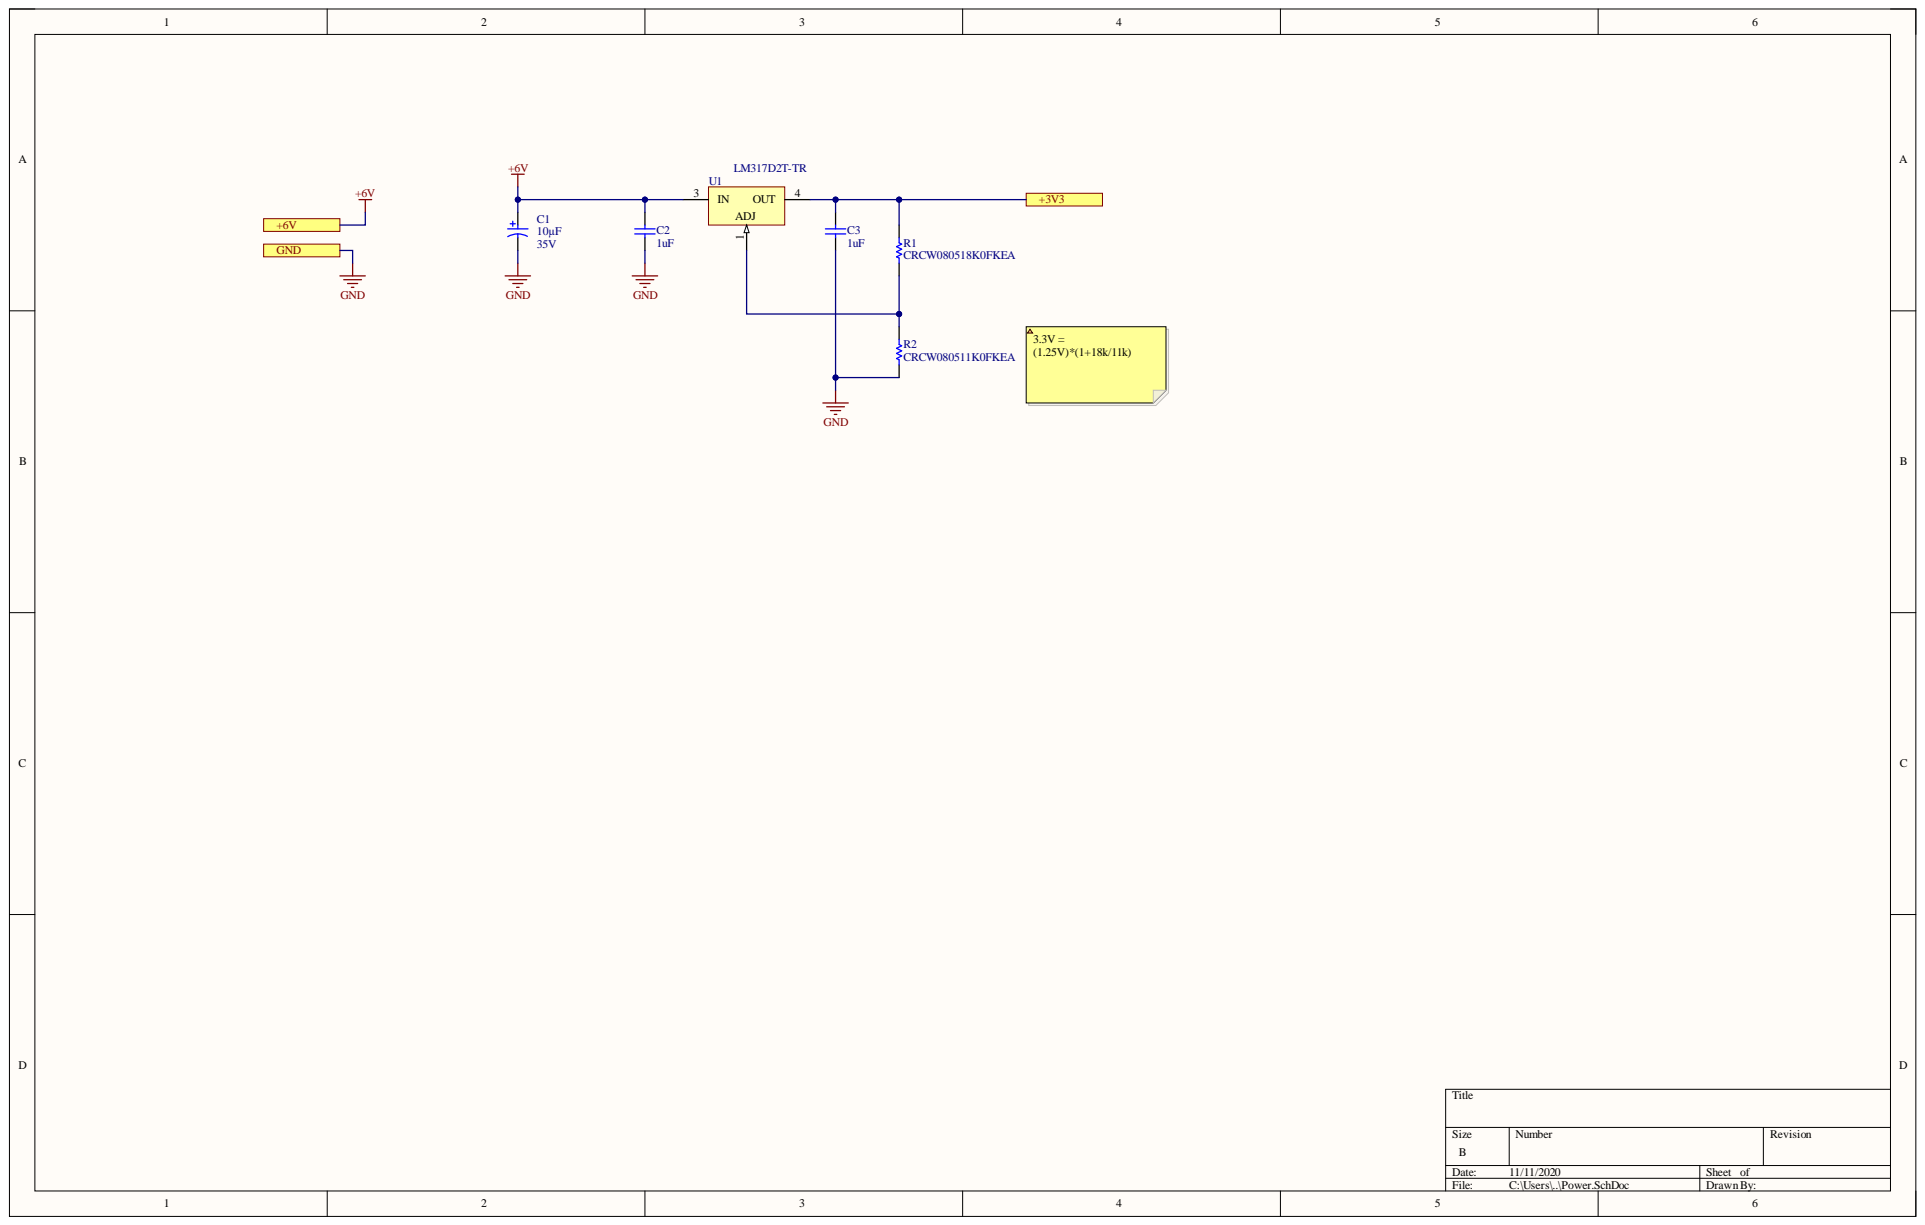
[picture p18: page 10]

Si z e | N umber | Revi s i on

e : 11/ 11/20 20 | Sheet of
Fi l e : C : \User s \..\Power.Sch Do c | D raw n B y :

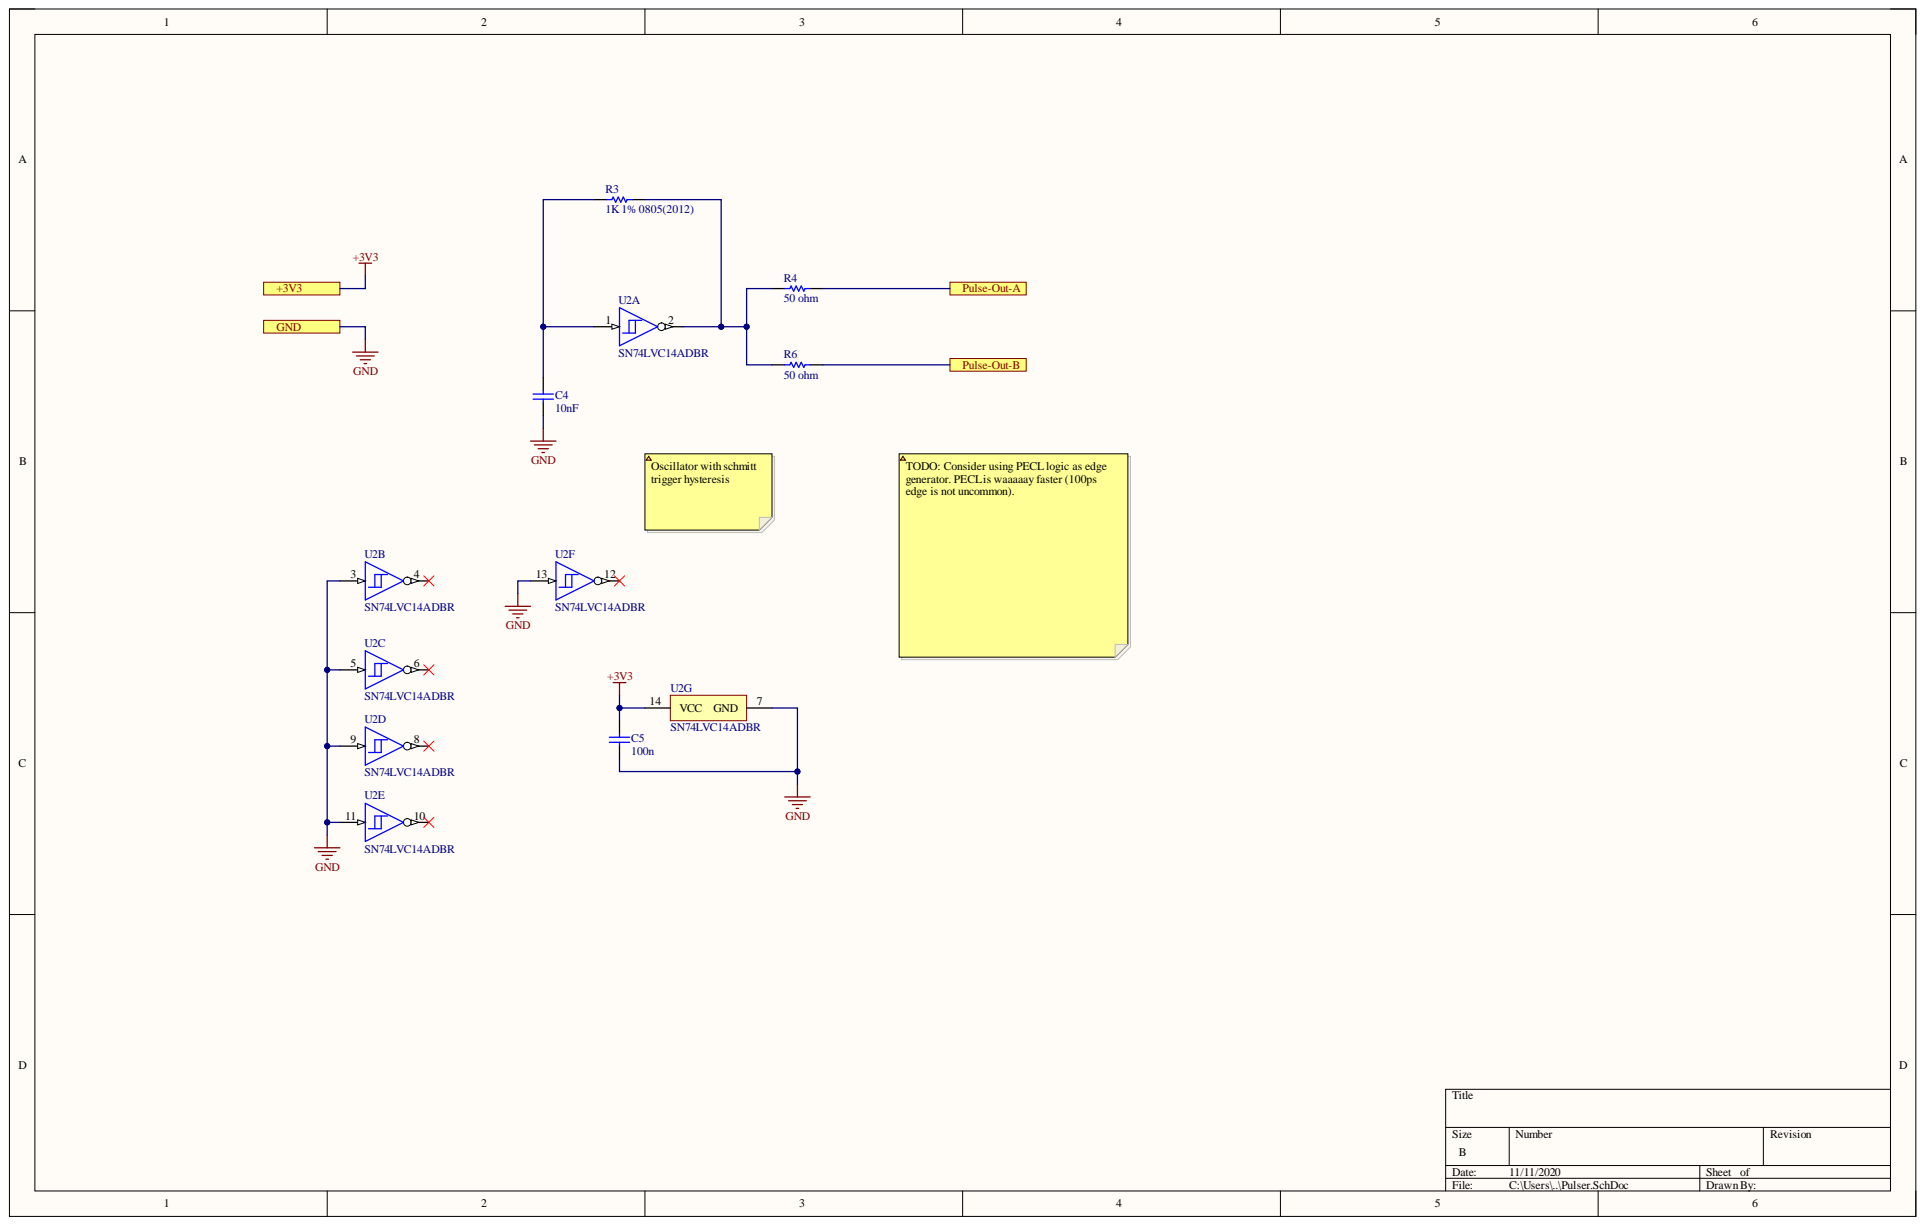
[picture p19: page 11]

TODO: Consider using PECL logic as edge
generator. PECLis waaaaay faster (100ps
edge is not uncommon).

Size B | Number | Revision

Date: 11/11/2020 | Sheet of
File: C:\Users\..\Pulser.SchDoc | DrawnBy:

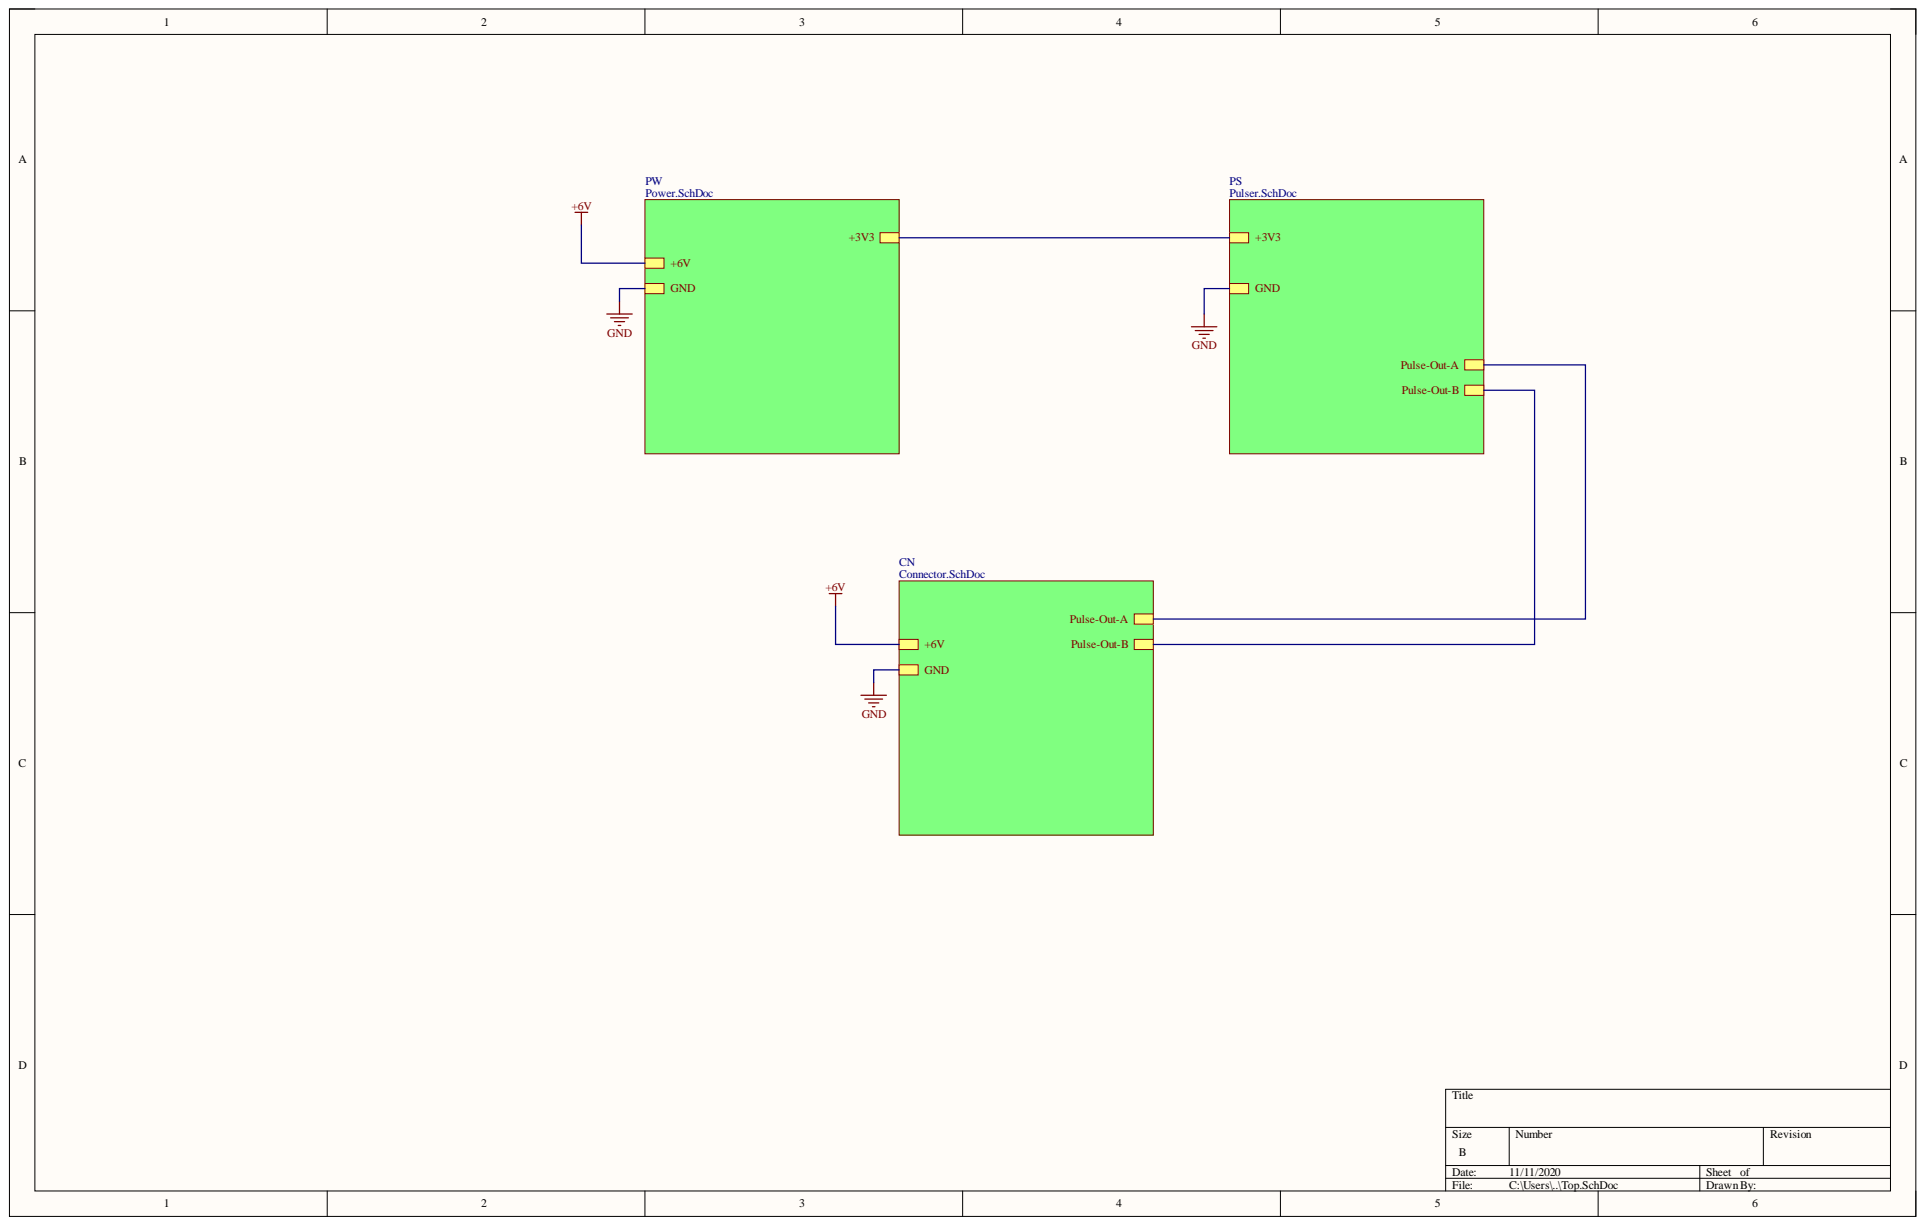
[picture p20: page 12]

Size B | Number | Revision

Date: 11/11/2020 | Sheet of
File: C:\Users\..\Top.SchDoc | DrawnBy:

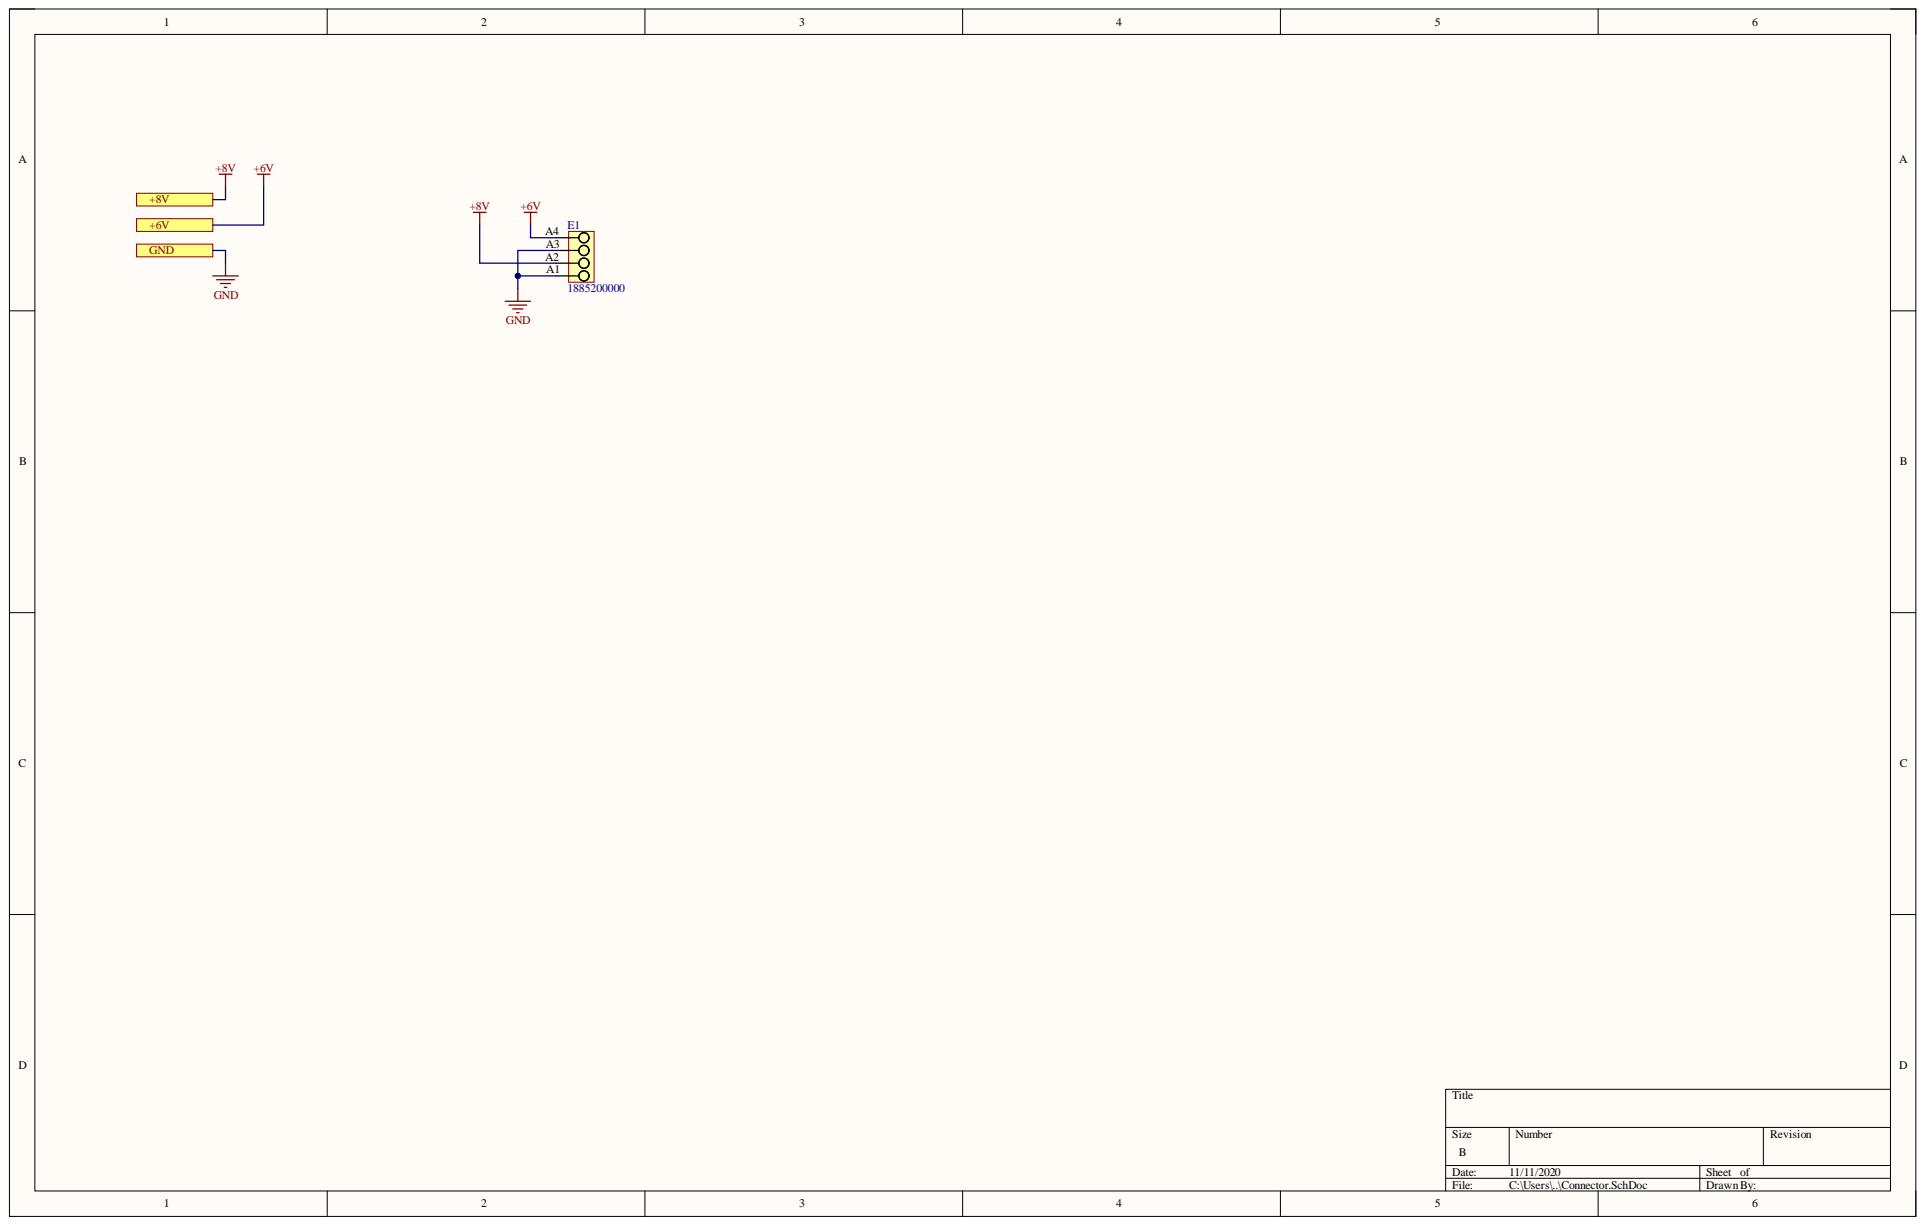
[picture p21: page 13]

Si z e | N umber | Revi s i on

e : 11/ 11/20 20 | Sheet of
Fi l e : C : \User s \..\ Con nector.Sch Doc | D raw n B y :

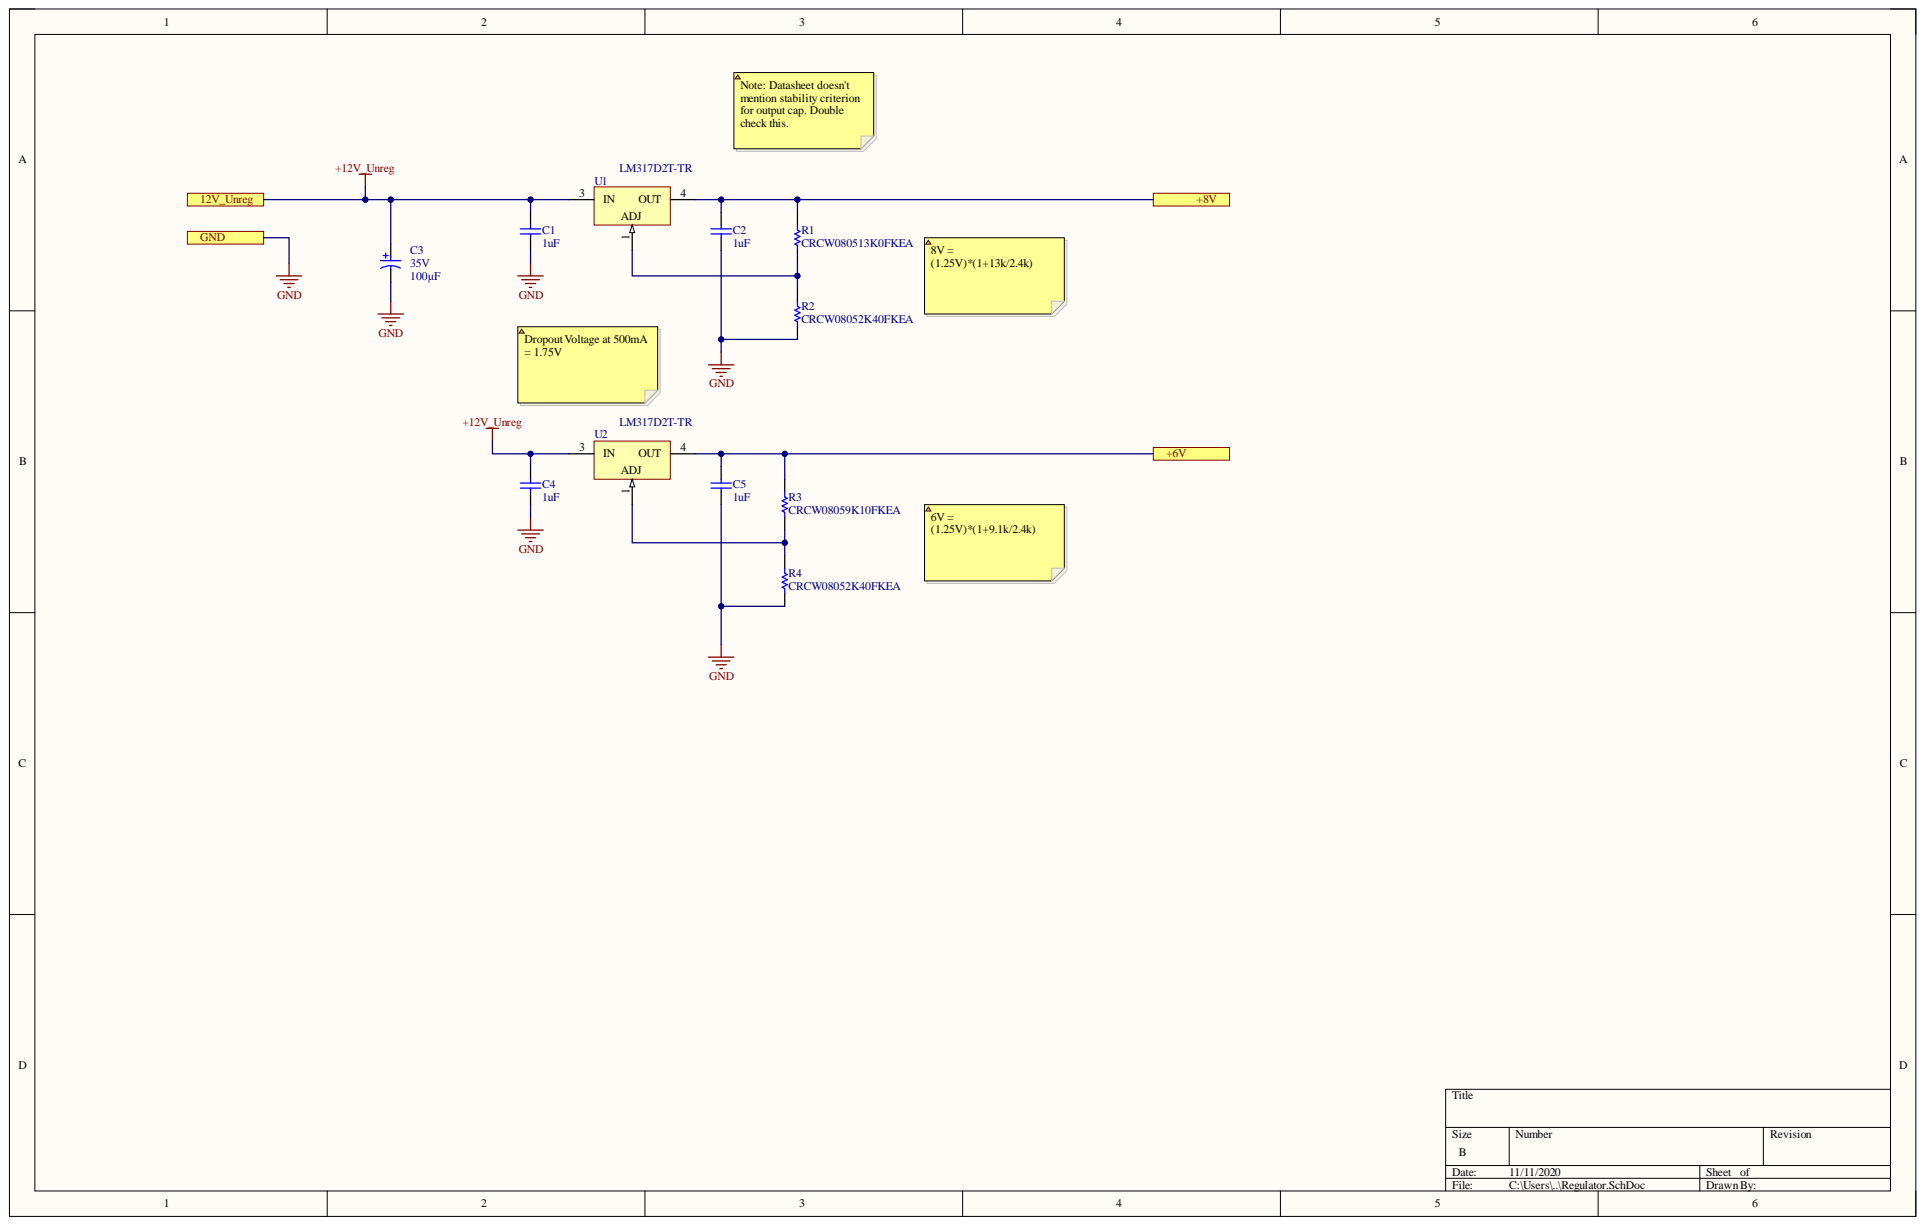
[picture p22: page 14]

Si z e | N umber | Revi s i on

e : 11/ 11/20 20 | Sheet of
Fi l e : C : \User s \..\ Reg ulator.Sch Doc | D raw n B y :

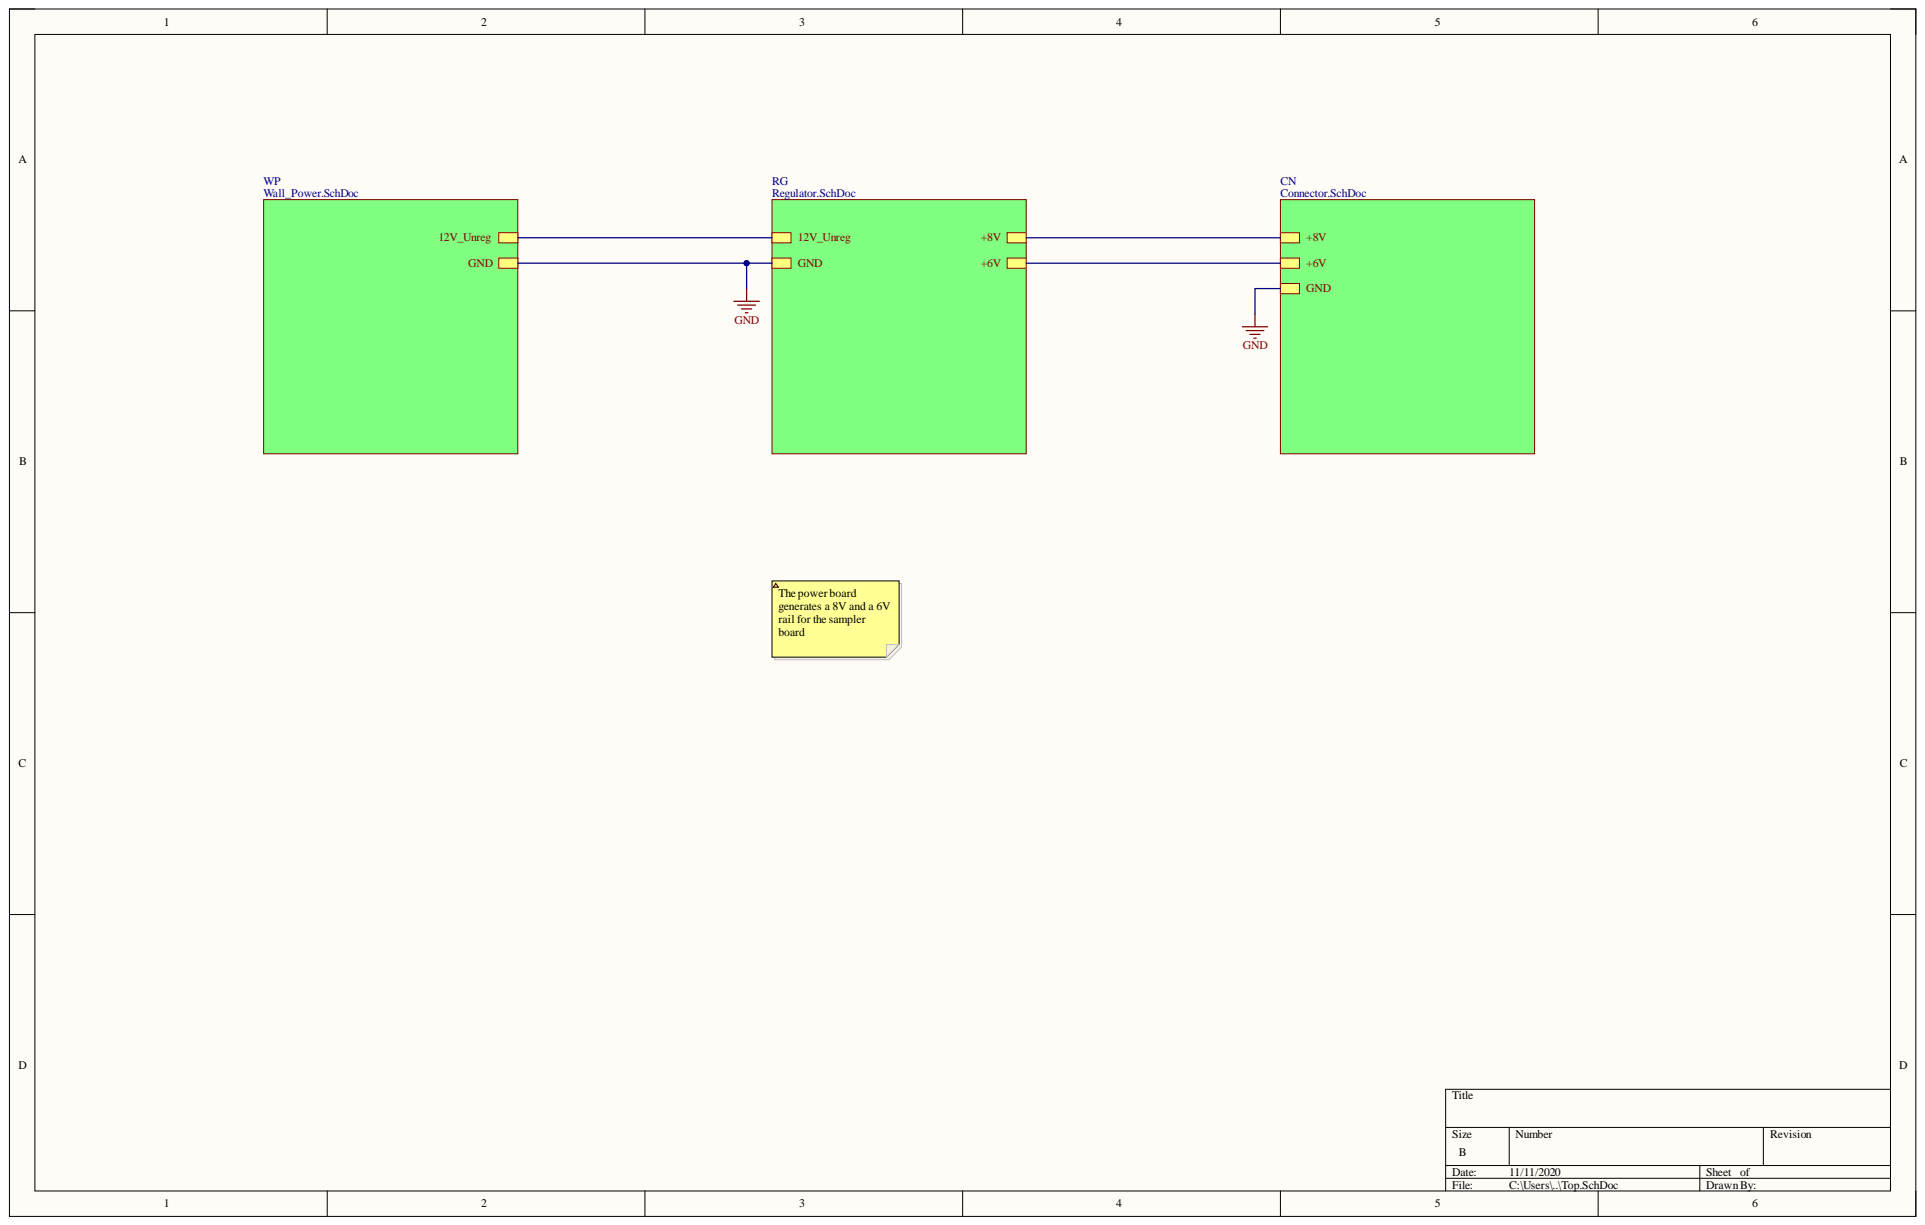
[picture p23: page 15]

The power board
generates a 8V and a 6V
rail for the sampler
board

Size B | Number | Revision

Date: 11/11/2020 | Sheet of
File: C:\Users\..\Top.SchDoc | DrawnBy:

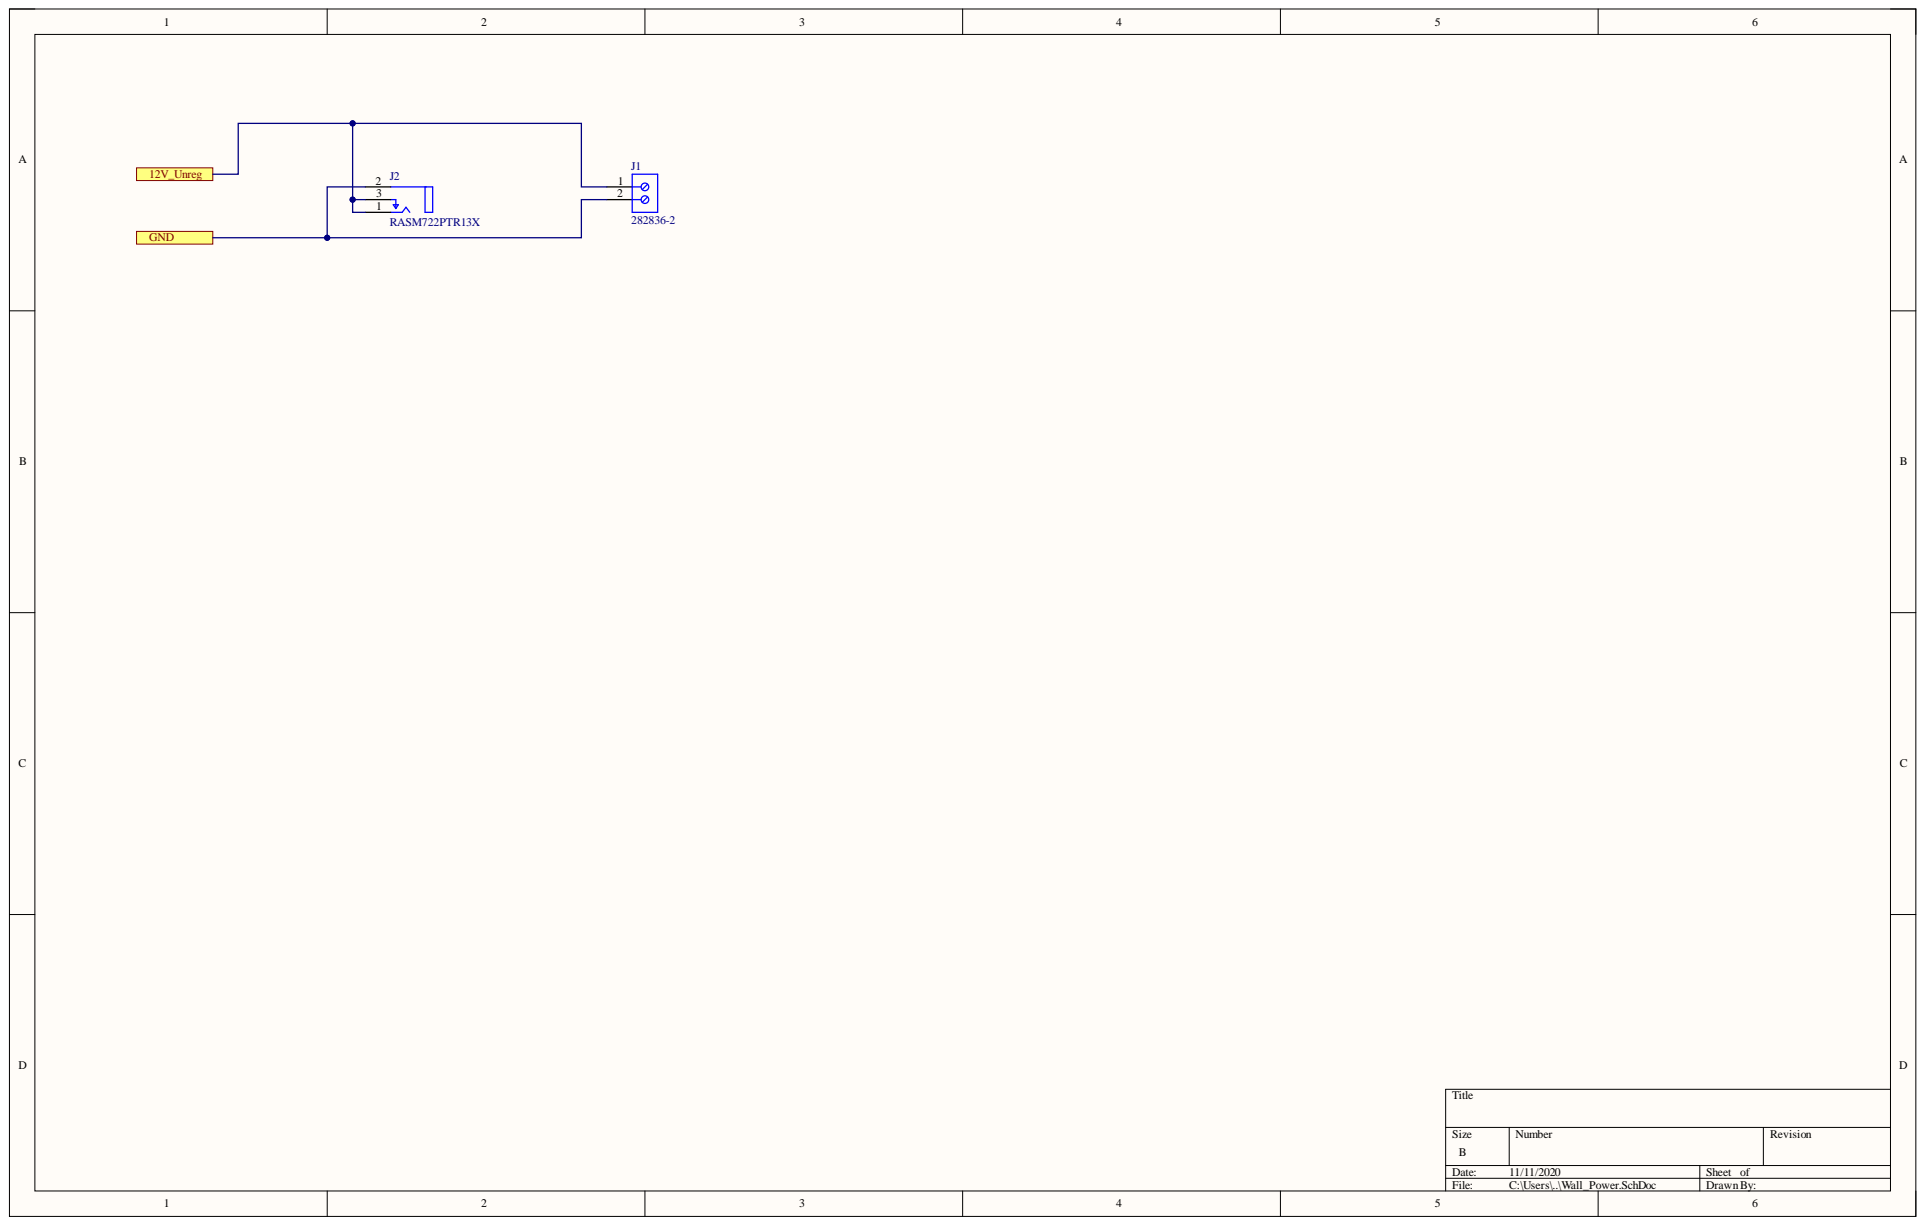
[picture p24: page 16]

Si z e | N umber | Revi s i on

e : 11/ 11/20 20 | Sheet of
Fi l e : C : \User s \..\Wal l_Power.Sch Do c | D raw n B y :
