wwerst/EE91Fall2020/(list of files, drawings)

Other design files:
PowerBoard/Connector.SchDoc
PowerBoard/PCB.PcbDoc
PowerBoard/PowerBoard.PrjPcb
PowerBoard/Regulator.SchDoc
PowerBoard/Top.SchDoc
PowerBoard/Wall_Power.SchDoc
PulseBoard/Connector.SchDoc
PulseBoard/PCB.PcbDoc
PulseBoard/Power.SchDoc
PulseBoard/PulseBoard.PrjPcb
PulseBoard/Pulser.SchDoc
PulseBoard/Top.SchDoc
SamplerBoard/CompareVoltage.SchDoc
SamplerBoard/Connector.SchDoc
SamplerBoard/CQFP80P1115X1115X120-32N.PcbLib
SamplerBoard/FPGA.SchDoc
SamplerBoard/Input-Comparator.SchDoc
SamplerBoard/Local_Parts.PcbLib
SamplerBoard/Local_Parts.SchLib
SamplerBoard/PCB.PcbDoc
SamplerBoard/Power.SchDoc
SamplerBoard/SamplerBoard.PrjPcb
SamplerBoard/Top.SchDoc
SamplerBoard/Trigger.SchDoc
TopLevelBlockDiagramPDR/BlockDiagram.SchDoc
TopLevelBlockDiagramPDR/LocalParts.SchLib
TopLevelBlockDiagramPDR/TopLevelBlockDiagram.PrjPcb
