wwerst/EE91Fall2020/(commit log)

2020-10-19 Add base projects
    [PowerBoard.PrjPcb, PulseBoard.PrjPcb, SamplerBoard.PrjPcb]
2020-10-19 Add Top files for Altium projects
    [PowerBoard.PrjPcb, PulseBoard.PrjPcb, SamplerBoard.PrjPcb, Top.SchDoc]
2020-10-21 Add Schematic sheets
    [Connector.SchDoc, FPGA.SchDoc, Input-Comparator.SchDoc, Power.SchDoc, Top.SchDoc, Trigger.SchDoc]
2020-10-21 Project files difference
    [SamplerBoard.PrjPcb]
2020-10-22 Add work from Wednesday afternoon
    [CompareVoltage.SchDoc, FPGA.SchDoc, Input-Comparator.SchDoc, Local_Parts.PcbLib, Local_Parts.SchLib, SamplerBoard.PrjPcb, Top.SchDoc]
2020-10-22 Additional changes during meeting
    [CompareVoltage.SchDoc, FPGA.SchDoc, Input-Comparator.SchDoc, Top.SchDoc]
2020-10-29 Add schematics changes presented at today's meeting.
    [Connector.SchDoc, Power.SchDoc, PowerBoard.PrjPcb, PulseBoard.PrjPcb, Pulser.SchDoc, Regulator.SchDoc, Top.SchDoc, Wall_Power.SchDoc]
2020-11-03 Add basic RF layout
    [CompareVoltage.SchDoc, Connector.SchDoc, FPGA.SchDoc, Input-Comparator.SchDoc, PCB.PcbDoc, Power.SchDoc, PowerBoard.PrjPcb, PulseBoard.PrjPcb]
2020-11-05 Add Top level diagram changes
    [BlockDiagram.SchDoc, CompareVoltage.SchDoc, Connector.SchDoc, Input-Comparator.SchDoc, LocalParts.SchLib, PCB.PcbDoc, Power.SchDoc, Pulser.SchDoc]
2020-11-06 Latest changes
    [Input-Comparator.SchDoc, Trigger.SchDoc]
2020-11-07 Schematic finished
    [CompareVoltage.SchDoc, Input-Comparator.SchDoc, Power.SchDoc, Pulser.SchDoc, Trigger.SchDoc]
2020-11-07 Save project file changes
    [PulseBoard.PrjPcb, SamplerBoard.PrjPcb, Top.SchDoc]
2020-11-09 Add BOM stuff
    [PowerBoard.PrjPcb, PulseBoard.PrjPcb, Pulser.SchDoc, SamplerBoard.PrjPcb]
2020-11-12 Rough placement of sampler board
    [CQFP80P1115X1115X120-32N.PcbLib, Connector.SchDoc, Input-Comparator.SchDoc, Local_Parts.PcbLib, Local_Parts.SchLib, PCB.PcbDoc, SamplerBoard.PrjPcb, Trigger.SchDoc]
2020-11-12 Add Place and route work
    [Connector.SchDoc, PCB.PcbDoc, PowerBoard.PrjPcb, PulseBoard.PrjPcb, SamplerBoard.PrjPcb, TopLevelBlockDiagram.PrjPcb]
2020-11-12 State after CDR
    [Connector.SchDoc, PCB.PcbDoc]
2020-11-18 Continue laying out sampler board
    [CompareVoltage.SchDoc, FPGA.SchDoc, PCB.PcbDoc]
2020-11-25 Changes to Pulse and Power board
    [PCB.PcbDoc]
2020-11-26 Add latest
    [CompareVoltage.SchDoc, PCB.PcbDoc, Power.SchDoc]
2020-11-26 Add changes from after design review
    [Connector.SchDoc, Input-Comparator.SchDoc, PCB.PcbDoc, Trigger.SchDoc]
2020-12-02 Fix some unrouted nets and polygons
    [PCB.PcbDoc, SamplerBoard.PrjPcb]
2020-12-03 DRC issues fixed for sampler board
    [SamplerBoard.PrjPcb]
2020-12-15 Just before adding ground stitching
    [Input-Comparator.SchDoc, SamplerBoard.PrjPcb, Top.SchDoc, Trigger.SchDoc]
2020-12-15 Board done
    [PCB.PcbDoc]
2020-12-15 Add latest changes
    [CompareVoltage.SchDoc, Input-Comparator.SchDoc, Power.SchDoc, SamplerBoard.PrjPcb, Trigger.SchDoc]
2020-12-15 Add BOM
    [PCB.PcbDoc, PowerBoard.PrjPcb, PowerBoard_BOM.xlsx, PulseBoard_BOM.xlsx, SamplerBoard_BOM.xlsx]
2020-12-15 BOM stuff and validating design
    [BlockDiagram.SchDoc, LocalParts.SchLib, TopLevelBlockDiagram.PrjPcb]
